4D-Game/CrazyComet/README.md

# CrazyComet

CrazyComet is a physical game wich can be controlled using gamepads. For more information take a look at the [documentation](https://Electronic-and-Computer-Engineering.github.io/CrazyComet/)
