4D-Game/CrazyComet/hardware/README.md

# Hardware
Plans and Gerber-Files for the needed Hardware
