4D-Game/CrazyComet/controller/README.md

# Streamer
Code for the streamer (e.g. Raspberry Pi)
