4D-Game/CrazyComet/docs/hardware/tower.md

# Tower

The tower is the central element of the playing field. It is used to move the comets around the playing field so every player has a chance to hit them.

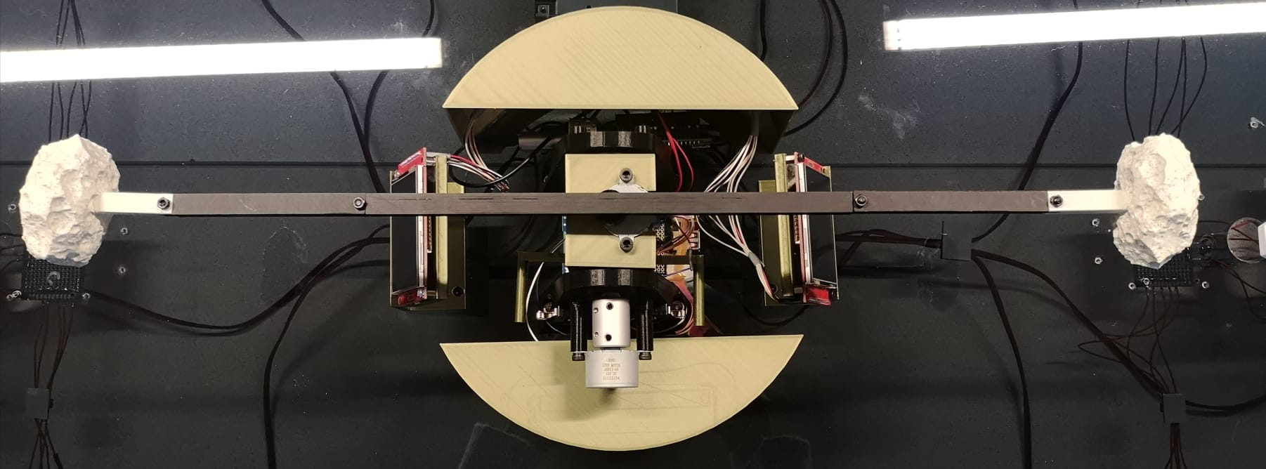
[picture p6: docs/assets/hardware/pictures/tower_top_view.jpeg]
View from the top


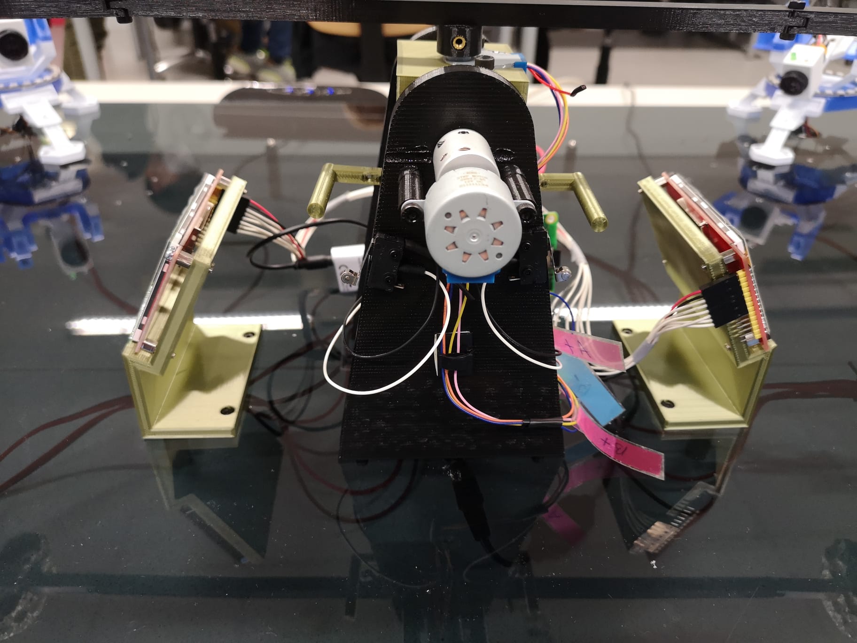
[picture p7: docs/assets/hardware/pictures/tower_side.jpeg]
View from the side


## Functionality

The tower consists of a base and an arm with a comet at each end. The arm can be rotated horizontally and tilted vertically. Both motions are created with a stepper motor. The stepper motors are controlled with the Raspberry Pi using a Adafruit Motor Shield. In order to avoid tilting too far  to the right or left, 2 end stoppers and physical limitation are built in.

## Technical characteristics

| Mechanical Device  | Action | State |
| --- | --- | --- |
| Side stepper motor | Tilting the tower | +-16° right/left max |
| Top stepper motor  | Arm rotation | Circular movement |

### 3D-Model

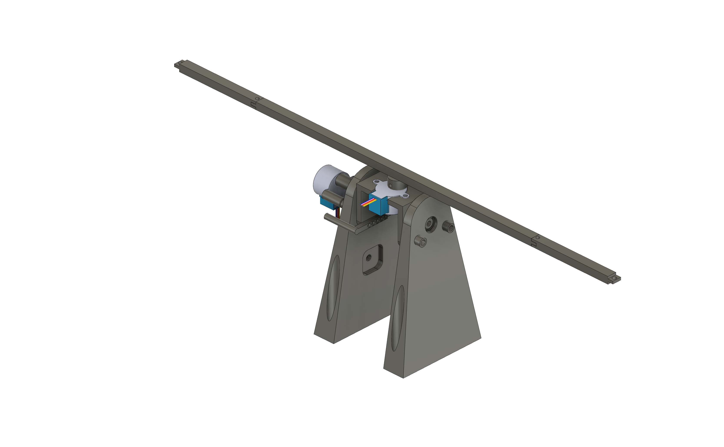
[picture p8: docs/assets/hardware/models/tower/tower_final.png]
CAD model of the tower


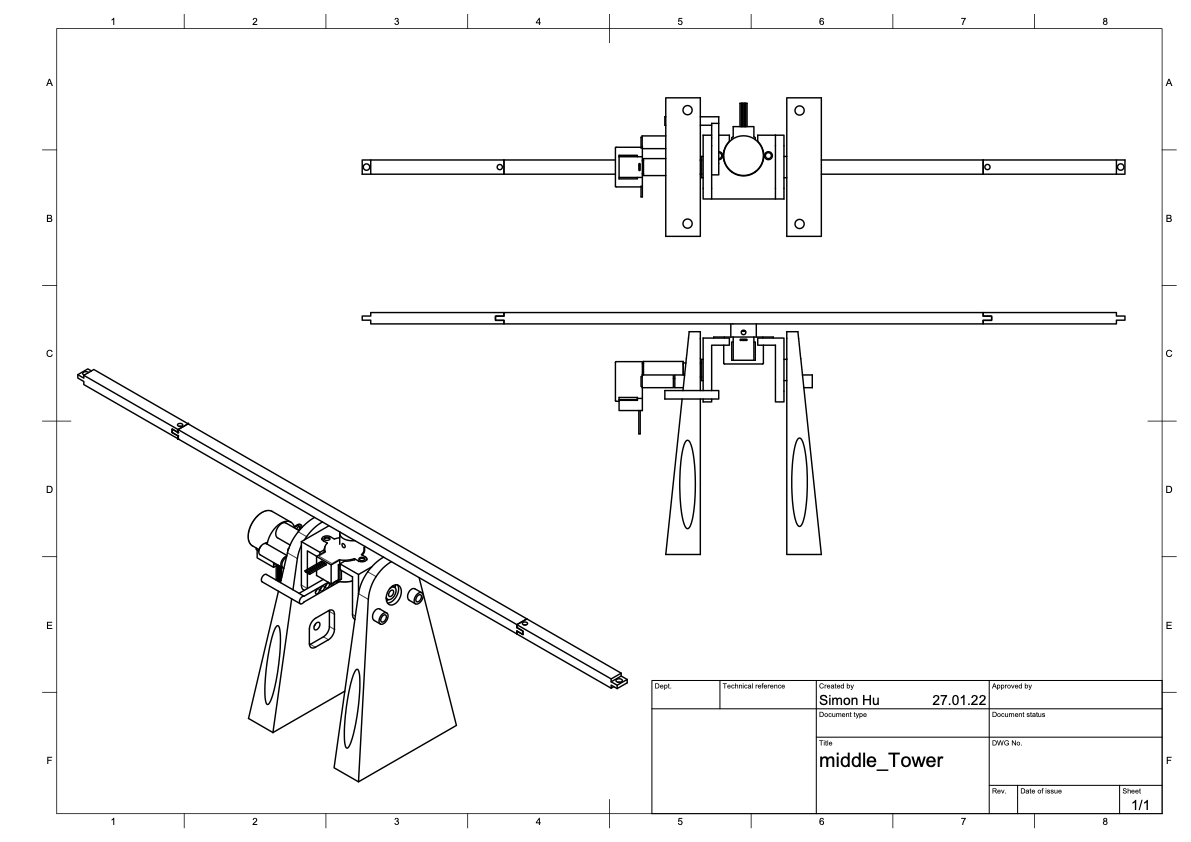
[picture p9: docs/assets/hardware/models/tower/tower_final_sketch.png]
CAD sketch of the tower


### Circuit (connection to Raspberry Pi)

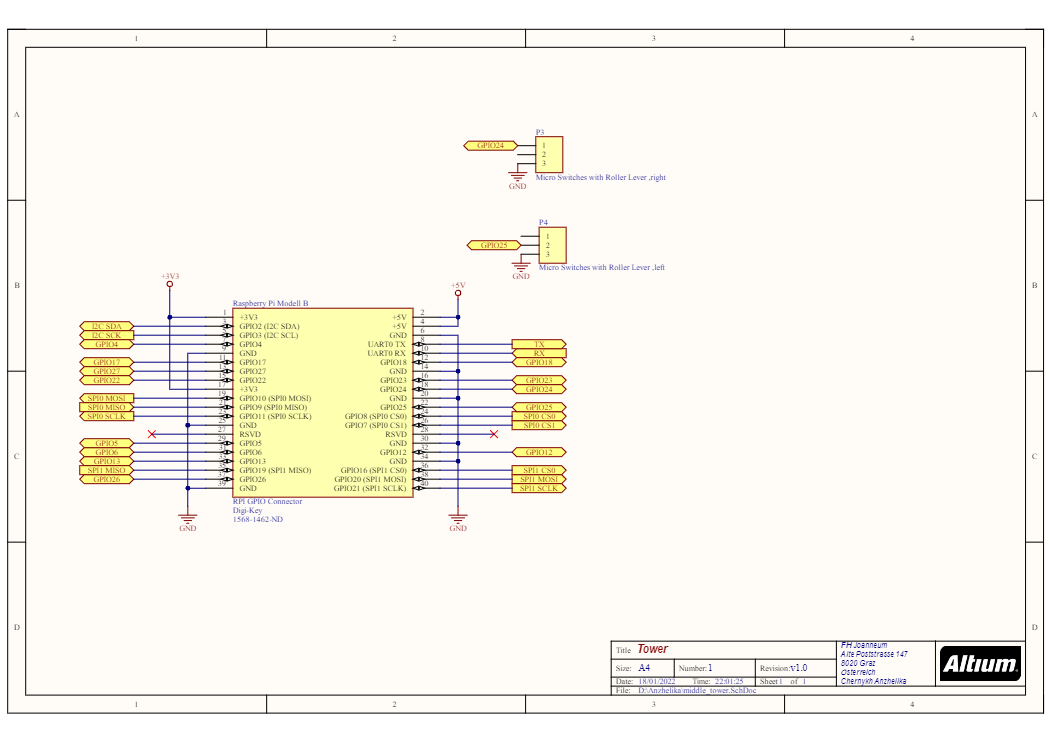
[picture p10: docs/assets/hardware/circuit/tower.png]
Middle Tower circuit


For the connection between motors, motor shield and Raspberry Pi see the [Adafruit documentation](https://learn.adafruit.com/adafruit-dc-and-stepper-motor-hat-for-raspberry-pi/stacking-hats)

## Components

For a list of all used components see the [components](components.md) section.

## Further information

All 3D-Models were done with Fusion360 and can be found on GitHub.
For information about controlling the tower via controller and software solutions please look [here](../gamecontrol/code-references/hardware/stepper_hal.md)
