4D-Game/CrazyComet/docs/gamecontrol/code-references/hardware/display_hal.md

# StepperHAL

:::gamecontrol.hardware.display_hal
