4D-Game/CrazyComet/docs/gamecontrol/code-references/hardware/sound_hal.md

# StepperHAL

:::gamecontrol.hardware.sound_hal
