4D-Game/CrazyComet/docs/gamecontrol/code-references/hardware/stepper_hal.md

# StepperHAL

:::gamecontrol.hardware.stepper_hal
