4D-Game/CrazyComet/docs/documentation.md

# Documentation

This documentation is generated by [MkDocs](https://www.mkdocs.org) with the [Material for MkDocs](https://squidfunk.github.io/mkdocs-material/) Theme. MkDocs is a static site generator wich uses Markdown as markup language. For a Markdown cheat sheet click [here](https://www.markdownguide.org/cheat-sheet).

## Setup

To use MkDocs the `requirements.txt` have to be installed with:

```bash
pip3 install -r requirements.txt
```

!!! INFO
    On the **Controller** and **Gamecontrol** Repository this only works on a Raspberry Pi

## Local build

To build the documentation for local use run:

```bash
mkdocs serve
```

Now you can access the documentation on the address shown in the terminal ([http://localhost:8000](http://localhost:8000))

!!! INFO
    When running on a Raspberry Pi execute the following command to access the Documentation from an other PC in the same network.

    ```bash
      mkdocs serve -a <ip of your raspberry pi>:8000
    ```

## Deploy

When the documentation is ready it can be uploaded to GitHub using:

```bash
mkdocs gh-deploy
```

This will automatically build an upload the site to GitHub using the branch *gh-pages*.

!!! WARNING
    Please avoid modifying the branch *gh-pages* manually.

## Useful Commands

### Diagrams

Diagrams can be created by using [mermaid](https://mermaid-js.github.io/mermaid/). Mermaid can be used by creating a code-block with the `mermaid` language tag.

````md
```mermaid
<your diagram>
```
````
