4D-Game/CrazyComet/docs/coding-style/cpp.md

# C++ Coding Style

Next to consistency as a main aspect of good code, the second most important aspect is a certain style which the average `c++` programmer is capable to read and understand properly. Therefore the following documents states the essential naming conventions.
> Here is a link for a more detailed dive into [`c++ core guidelines'](https://github.com/isocpp/CppCoreGuidelines/blob/master/CppCoreGuidelines.md)

## Naming conventions
### Variables

The name of a variable should be as accurate as possible and as short as possible at the same time.

*Example:*
```cpp
// don't
int x;
x = 10 + 5;
// do
int sum
sum = 10 + 5;
```
A variable can be used in two different scenarios.

**Global variables** are defined outside of all functions, usually on top of the program. The variable will hold their value throughout the lifetime of the program.
Global variables should be defined in a **snake_case** style, when possible at the start of the file.

*Example:*
```cpp
int global_variable;
```

**Local variables** are defined, initially set and consumed within a function, method or block. These variables lifetime is confined within the lifetime (time of execution) of a function (method or block).
Local variables should be defined the same way as global variables. The main difference for local variables is a defined prefix `m_`. `m_` stands for "member" data.
```cpp
int m_local_variable;
```

### Constants & Preprocessor Values
Constants are expressions with a fixed value. They are defined with the *key* `const. The naming convention for constants and preprocessor values prescribes that all letters are upper case letters with snake case subdivision

*Example:*
```cpp
#define PI_VALUE 3.14159

const int PI_VALUE = 3.14159;
```

### Functions
Functions can be written as *non-returning* and *returning* type. They should start with a **lower case** letter. The following word should be **upper case**. This method is called *camelCase*

*Example:*
```cpp
void exampleFuntion() {
   // do some stuff
}
```

### Classes (Types, Template parameters)
`C++` is a object-oriented programming language. Therefore it's all about creating objects which contain both data and functions for a certain task.

A class as well as an object should be defined with **PascalCase** notation.

*Example:*
```cpp
class Car {
  public:
    string brand;
    int max_speed;
    int power;
    Car(string ini_brand, int ini_speed, ini_power){
       brand = ini_brand;
       max_speed = ini_speed;
       power = ini_power;
    }

  private:
    int m_current_speed;
};

void GeneralCar::setSpeed(int new_speed){
    m_current_speed = new_speed;
}

int main(){
   // declaration of two objects
   Car car1("Auto1", 200, 100);
   Car car2("Auto2", 300, 200);

   //setting the speed
   car1.setSpeed(250);

   return 0;
}
```

### Comments
If the section of code is not clearly understandable there should be a short description of the current function in form of a comment.

*Example*
```cpp
// divides up two double values
double division(double dividend, double divisor){
   return (dividend / divisor);
}
```

**Documentation:**

The documentation of the written code is created automatically. To provide the needed Information every function, class or method needs a descriptive block comment (`/** */`) with a special format.
> For a detailed explanation click [here](https://www.doxygen.nl/manual/docblocks.html)

*Example:*
```cpp
/**
  <Description>

  @param some_variable
  <Description of some_variable>

  @return <Description>
*/
int someFunction(char some_variable) {

}
```

**Head of File:**

In order to get quick information about the `.cpp` and `.hpp` files purpose there should be a *Header* comment included. Therefor the `/** */` format of commenting should be used.

*Example:*
```cpp
/**
  <Short description of the files function>

  Projekt:           <Name of the Projekt>
  Author:            <Authors Name>
  Date of Creation:  <Date>
*/
```
