4D-Game/CrazyComet/docs/assets/concept.jpeg

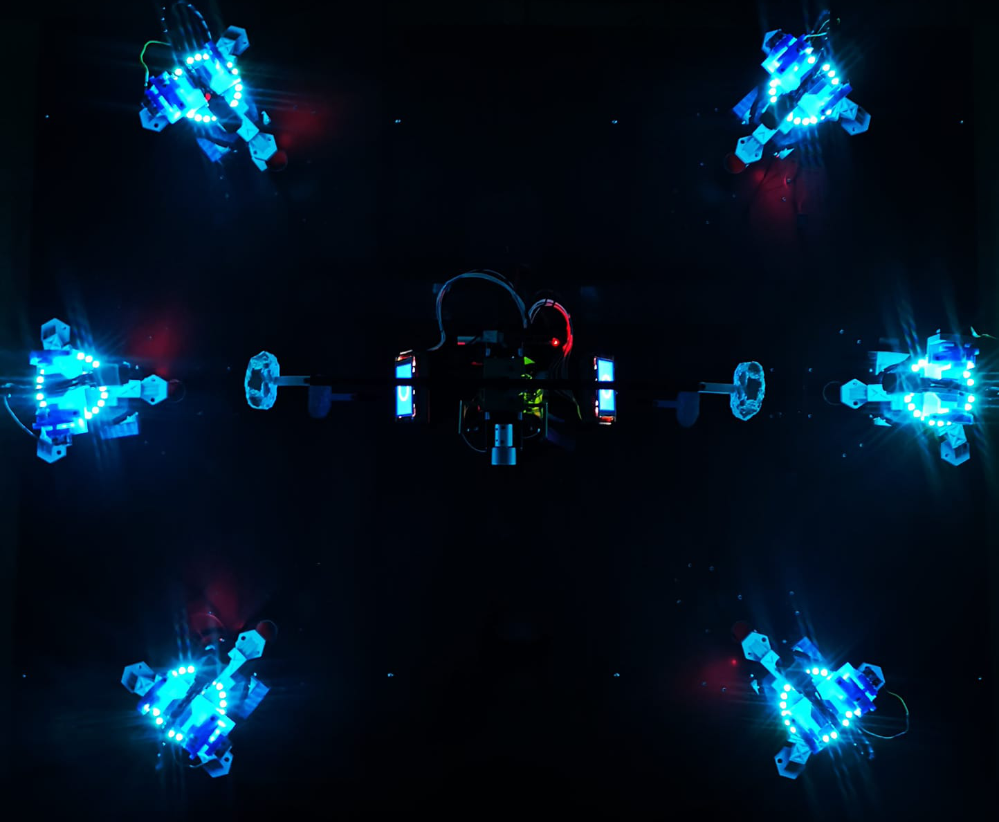
docs/assets/concept.jpeg
