4D-Game/CrazyComet/docs/assets/hardware/models/tower/tower_v1.png

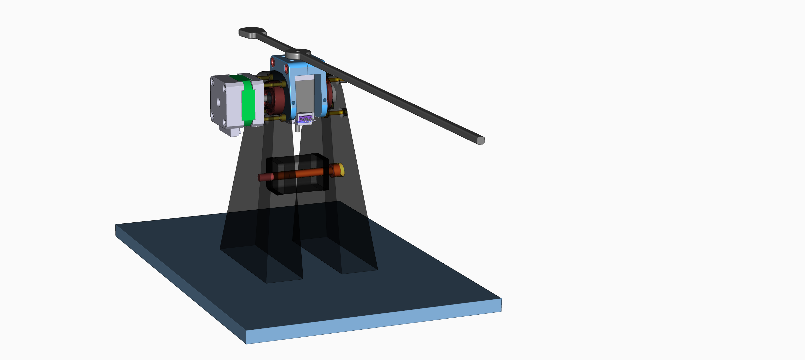
docs/assets/hardware/models/tower/tower_v1.png
