4D-Game/CrazyComet/docs/assets/hardware/models/turrets/base.png

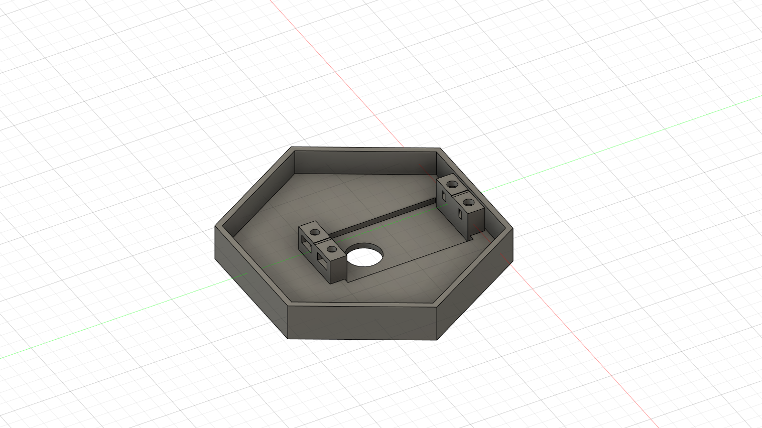
docs/assets/hardware/models/turrets/base.png
