4D-Game/CrazyComet/docs/assets/hardware/models/turrets/base_mount.png

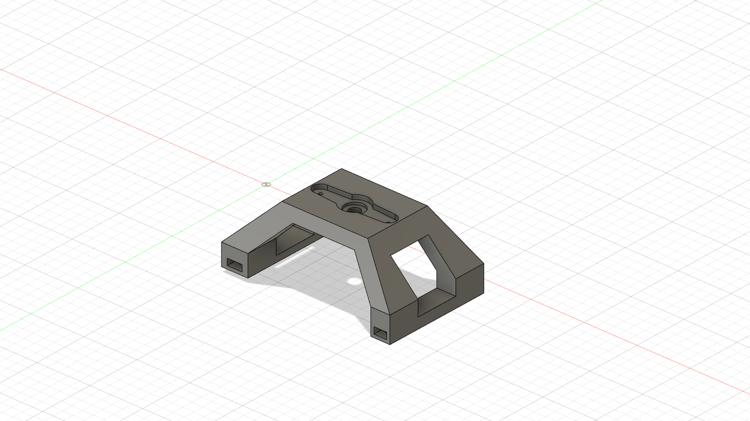
docs/assets/hardware/models/turrets/base_mount.png
