4D-Game/CrazyComet/docs/assets/hardware/models/turrets/blaster_arm.png

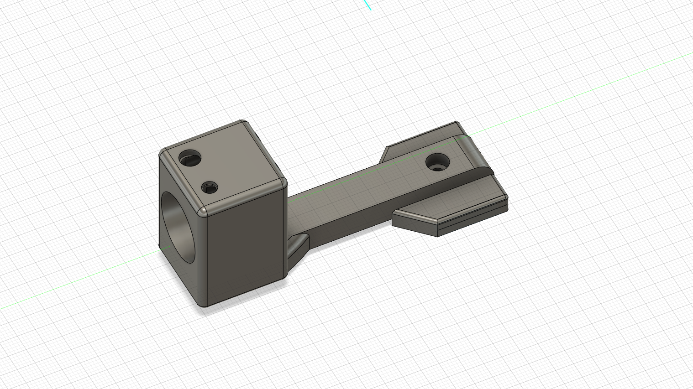
docs/assets/hardware/models/turrets/blaster_arm.png
