4D-Game/CrazyComet/docs/assets/hardware/models/turrets/end_bearing.png

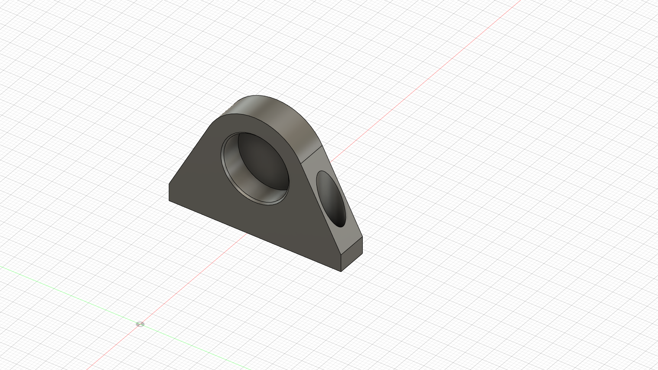
docs/assets/hardware/models/turrets/end_bearing.png
