4D-Game/CrazyComet/docs/assets/hardware/models/turrets/full_turret.png

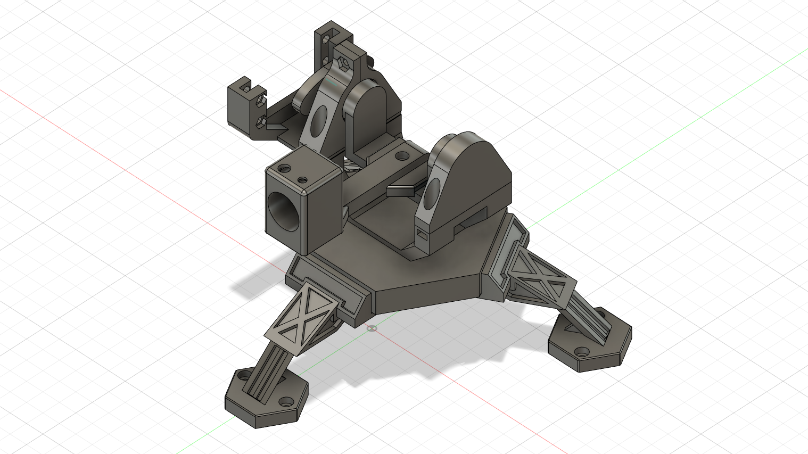
docs/assets/hardware/models/turrets/full_turret.png
