4D-Game/CrazyComet/docs/assets/hardware/models/turrets/left_right_bearing_half.png

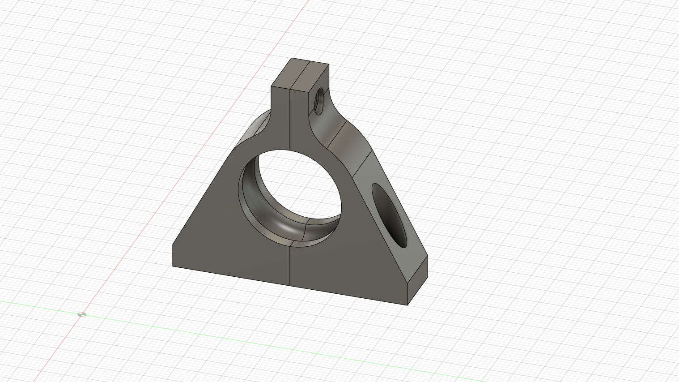
docs/assets/hardware/models/turrets/left_right_bearing_half.png
