4D-Game/CrazyComet/docs/assets/hardware/models/turrets/leg.png

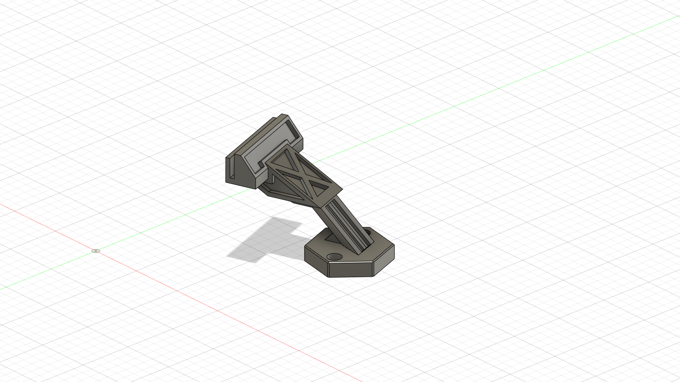
docs/assets/hardware/models/turrets/leg.png
