4D-Game/CrazyComet/docs/assets/hardware/models/turrets/turret_top.png

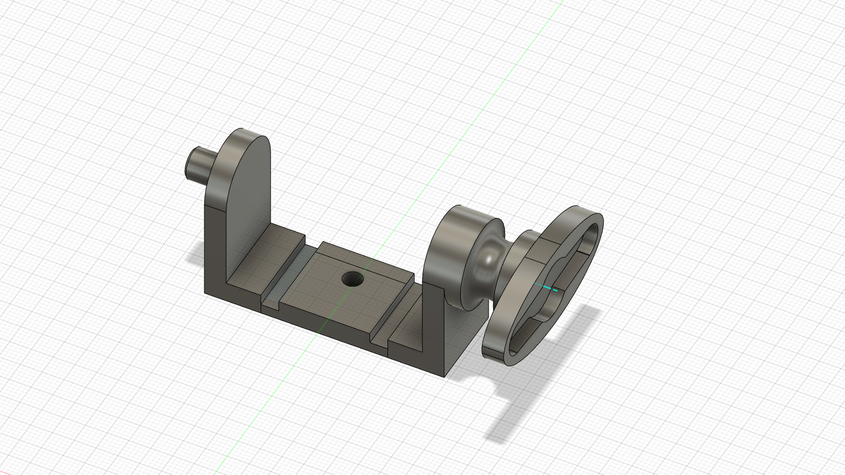
docs/assets/hardware/models/turrets/turret_top.png
