4D-Game/CrazyComet/docs/assets/hardware/models/turrets/vertical_servo_mount.png

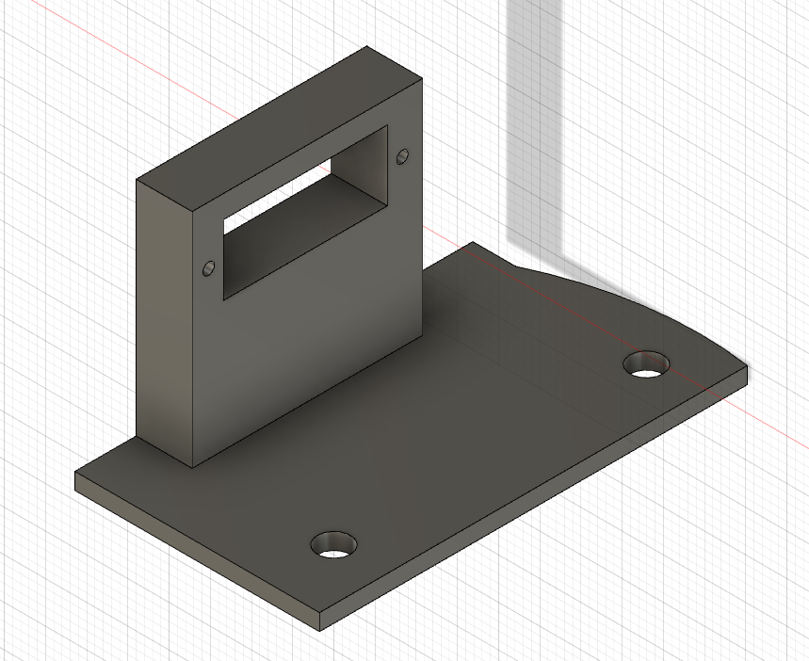
docs/assets/hardware/models/turrets/vertical_servo_mount.png
