4D-Game/CrazyComet/docs/assets/hardware/pictures/concept.jpeg

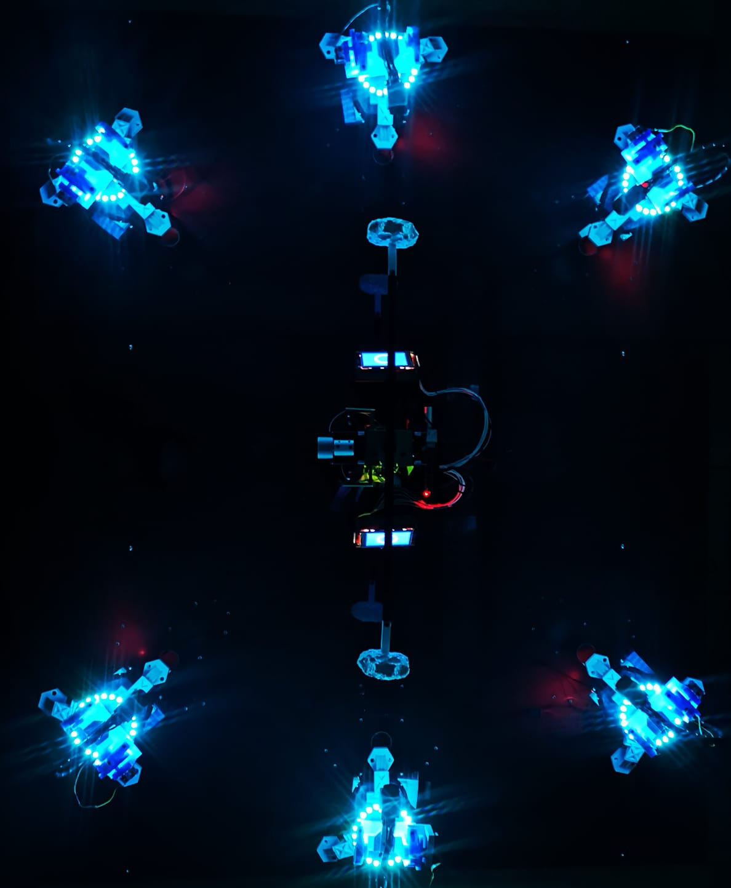
docs/assets/hardware/pictures/concept.jpeg
