4D-Game/CrazyComet/docs/assets/hardware/pictures/turret_front.jpeg

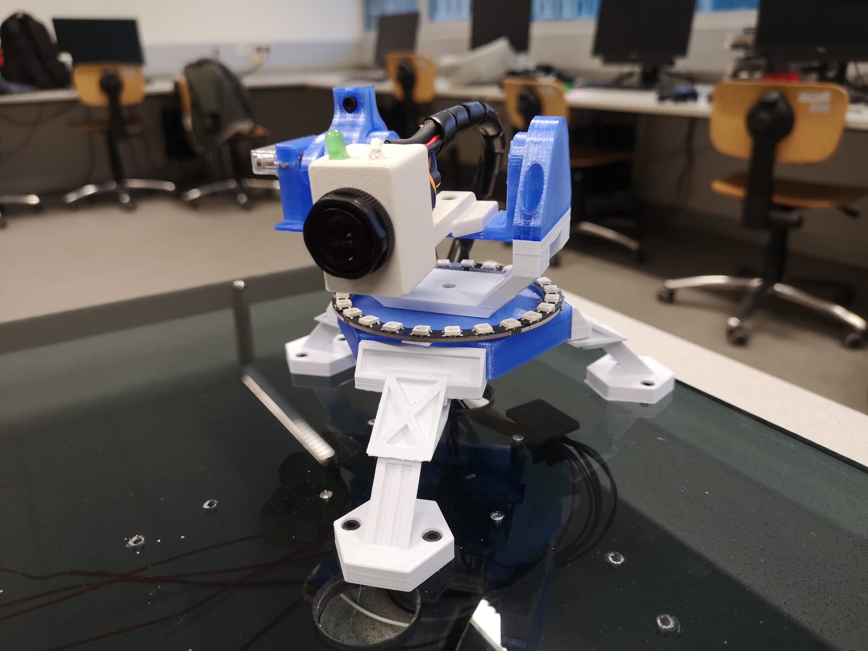
docs/assets/hardware/pictures/turret_front.jpeg
