4D-Game/CrazyComet/docs/assets/hardware/pictures/turret_left.jpeg

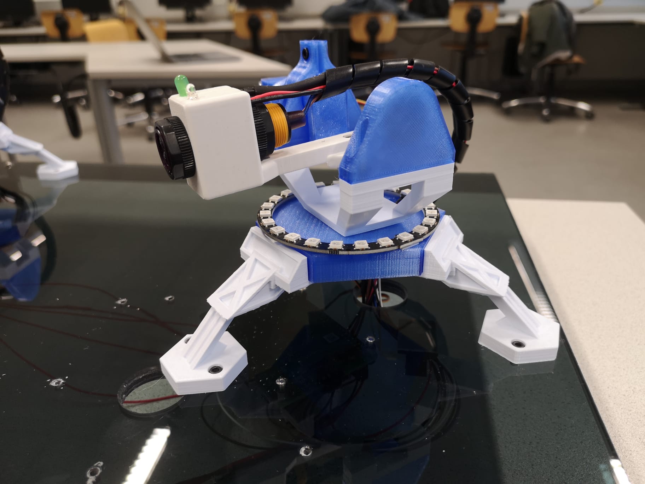
docs/assets/hardware/pictures/turret_left.jpeg
