4D-Game/CrazyComet/docs/assets/hardware/pictures/turret_top.jpeg

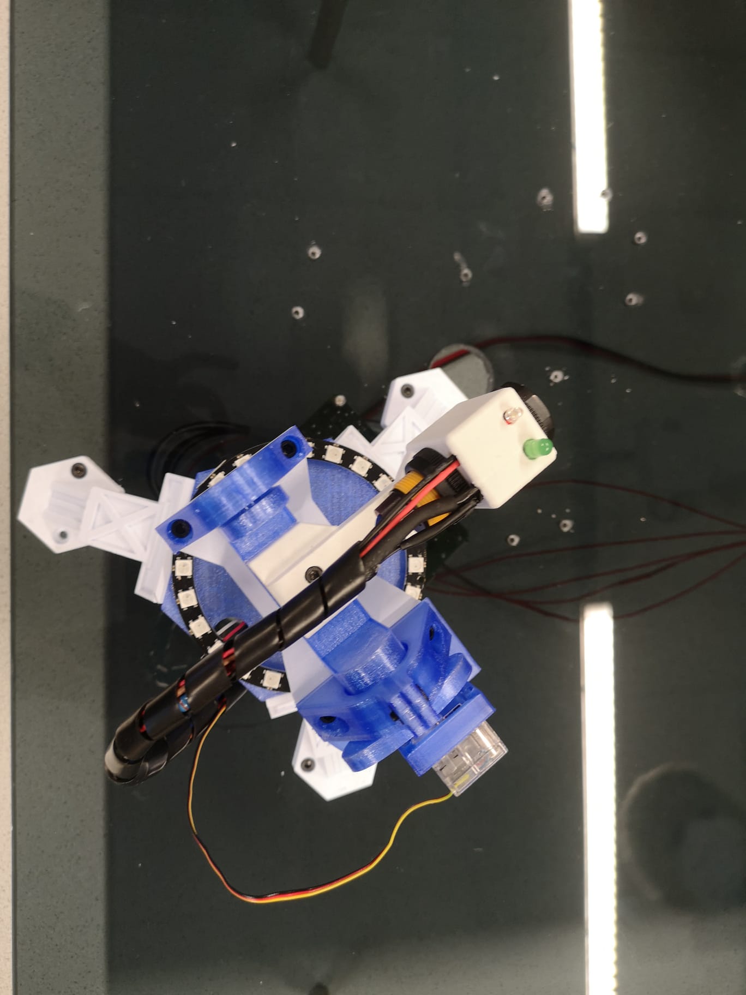
docs/assets/hardware/pictures/turret_top.jpeg
