4D-Game/CrazyComet/docs/assets/hardware/models/base_plate/base_plate.stl

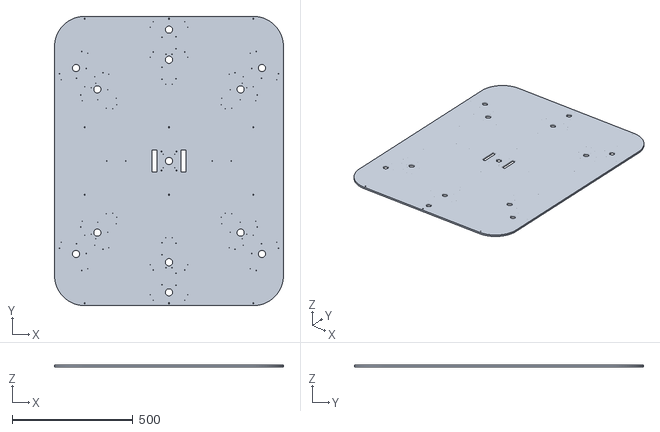
[picture p32: CAD file, 2022-03-05]
docs/assets/hardware/models/base_plate/base_plate.stl
950.0 x 1200.0 x 8.00
