4D-Game/CrazyComet/docs/assets/hardware/models/display/display_mount.stl

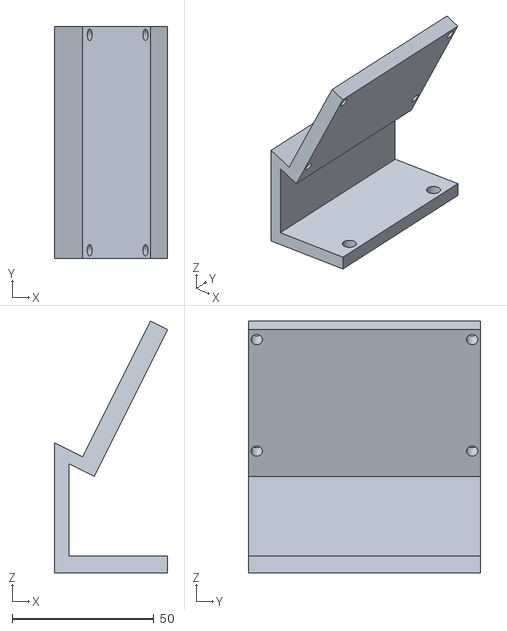
[picture p33: CAD file, 2022-03-05]
docs/assets/hardware/models/display/display_mount.stl
40.0 x 82.0 x 88.9
