4D-Game/CrazyComet/docs/assets/hardware/models/tower/tower.stl

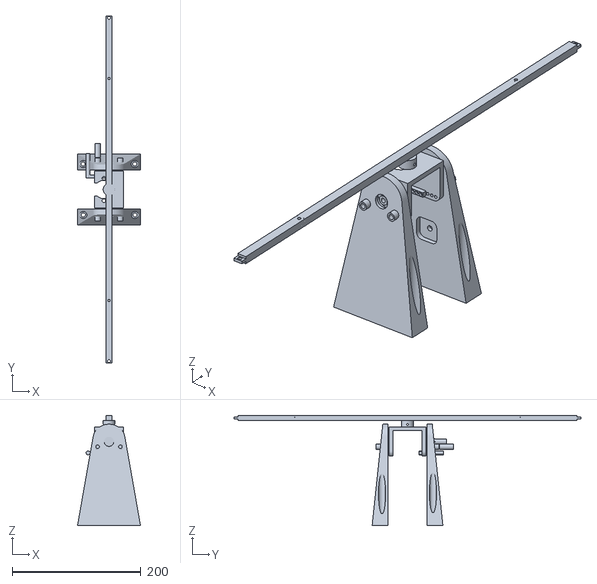
[picture p34: CAD file, 2022-03-05]
docs/assets/hardware/models/tower/tower.stl
97.7 x 538.1 x 170.6
