4D-Game/CrazyComet/docs/assets/hardware/models/turrets/blanko_hyx_s3001/servo_adapter_blanko.stl

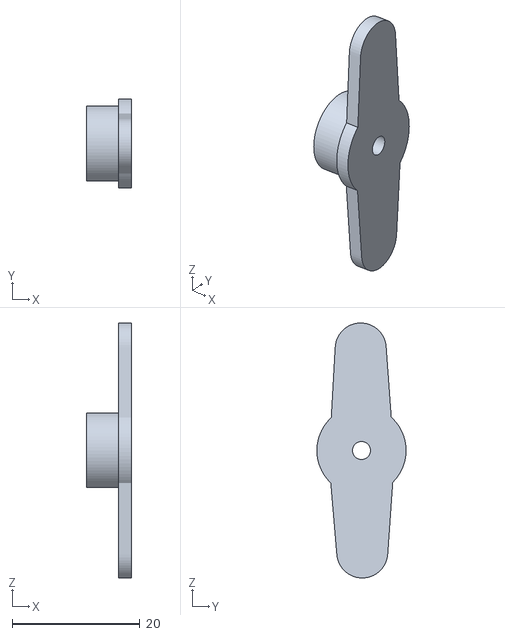
[picture p35: CAD file, 2022-03-05]
docs/assets/hardware/models/turrets/blanko_hyx_s3001/servo_adapter_blanko.stl
7.00 x 14.0 x 40.0
