4D-Game/CrazyComet/docs/assets/hardware/models/turrets/turret_top.stl

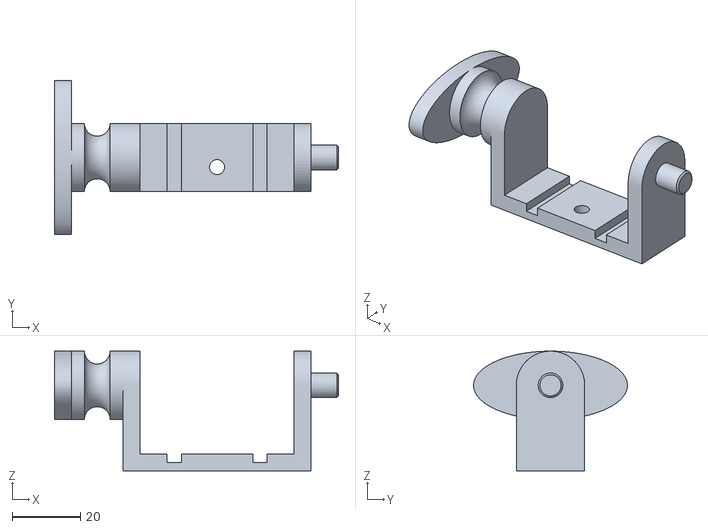
[picture p36: CAD file, 2022-03-05]
docs/assets/hardware/models/turrets/turret_top.stl
83.0 x 45.0 x 35.0
