4D-Game/CrazyComet/hardware/models/turrets/blanko_hyx_s3001/servo_bracket_blanko.stl

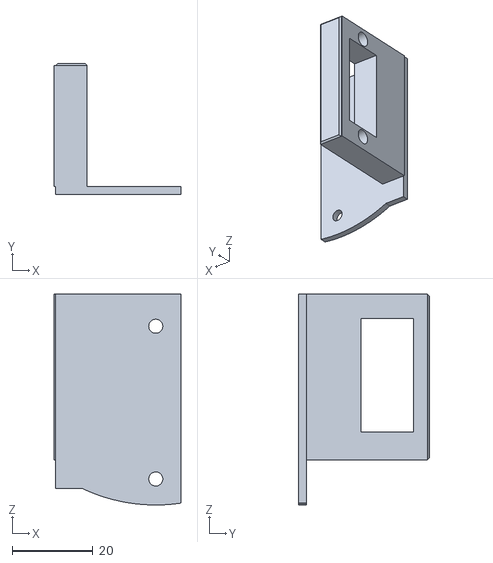
[picture p37: CAD file, 2022-03-05]
hardware/models/turrets/blanko_hyx_s3001/servo_bracket_blanko.stl
31.5 x 32.5 x 52.4
