4D-Game/CrazyComet/hardware/models/turrets/end_bearing.stl

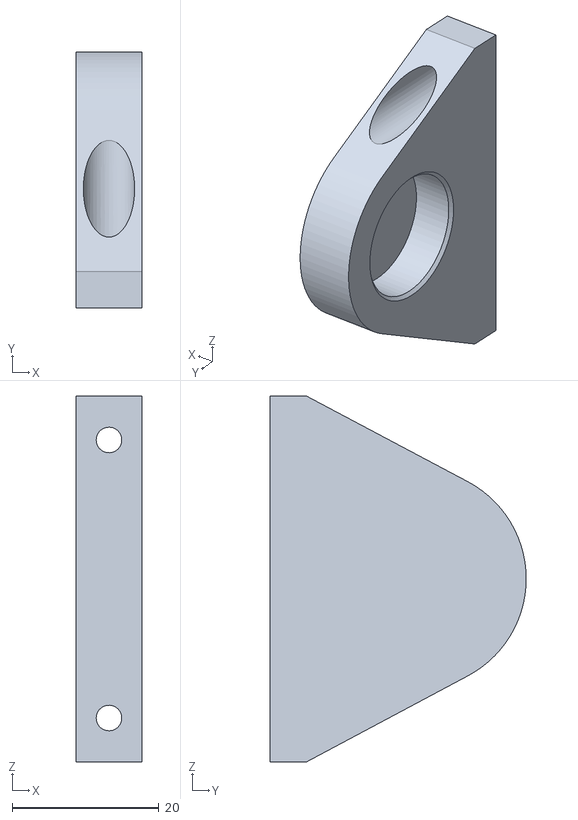
[picture p38: CAD file, 2022-03-05]
hardware/models/turrets/end_bearing.stl
9.00 x 35.0 x 49.9
