4D-Game/CrazyComet/docs/assets/hardware/models/turrets/base.stl

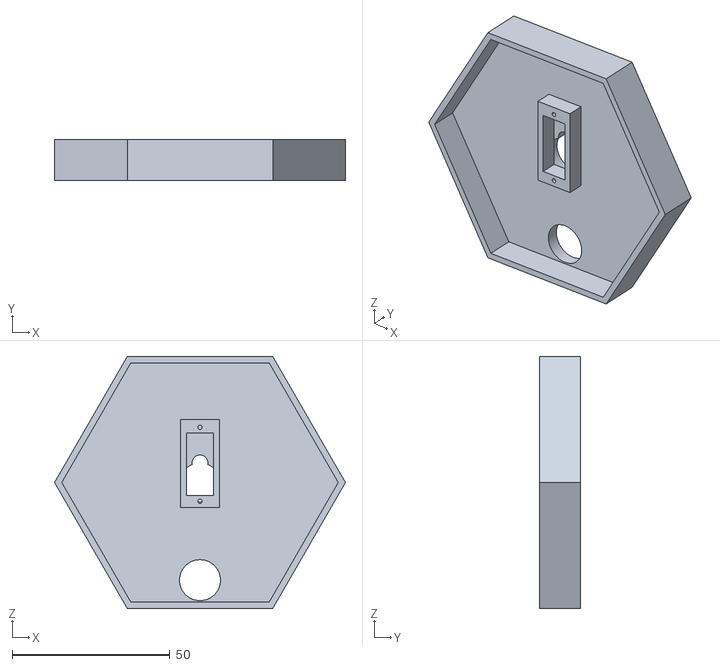
[picture p39: CAD file, 2022-03-05]
docs/assets/hardware/models/turrets/base.stl
92.4 x 13.0 x 80.0
