4D-Game/CrazyComet/hardware/models/turrets/leg.stl

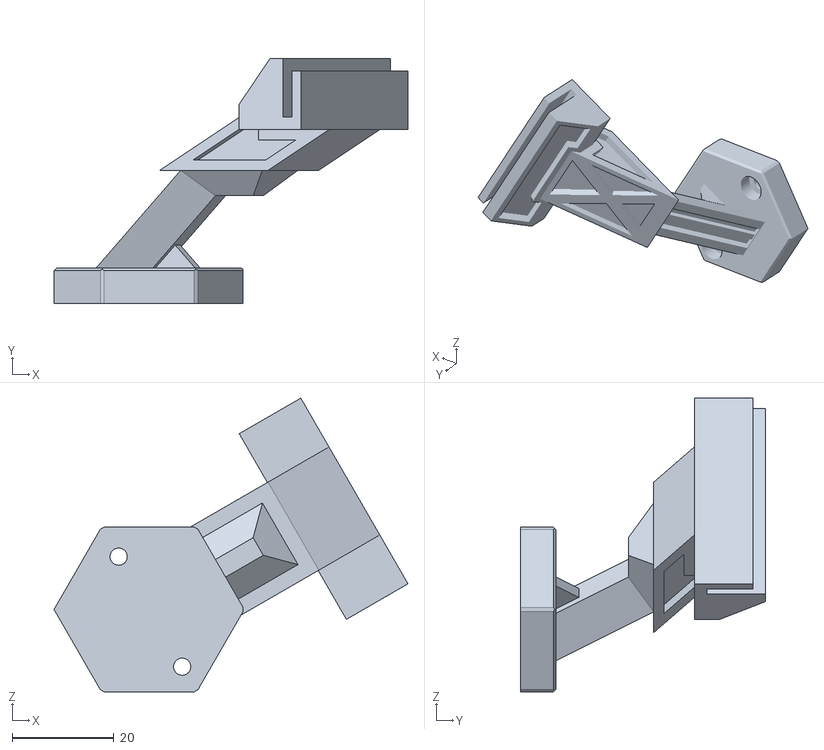
[picture p40: CAD file, 2022-03-05]
hardware/models/turrets/leg.stl
69.7 x 48.2 x 57.8
