4D-Game/CrazyComet/docs/assets/hardware/models/turrets/vertical_servo_mount_v2.stl

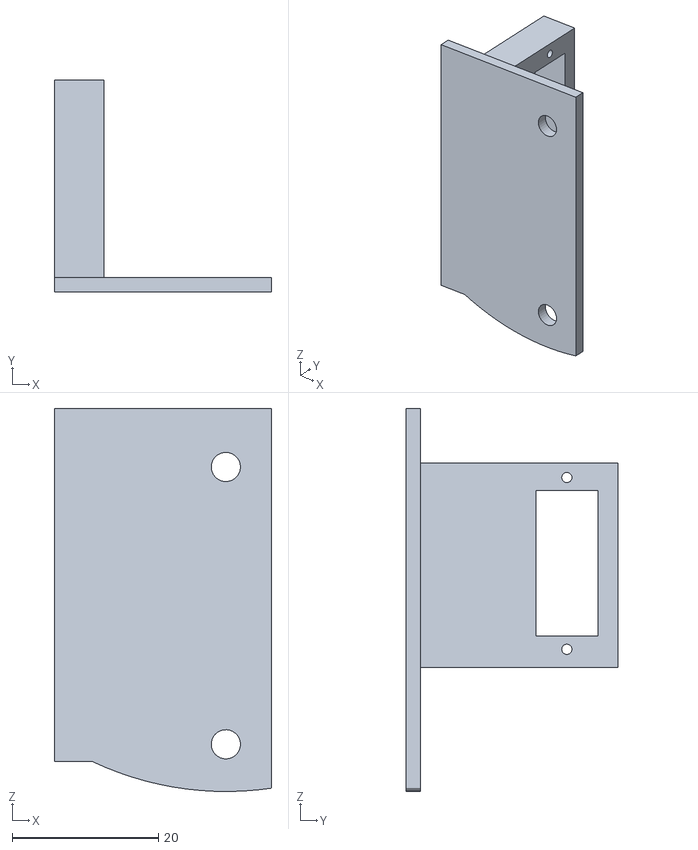
[picture p41: CAD file, 2022-03-05]
docs/assets/hardware/models/turrets/vertical_servo_mount_v2.stl
29.7 x 29.0 x 52.4
