4D-Game/CrazyComet/docs/assets/hardware/models/turrets/base_mount.stl

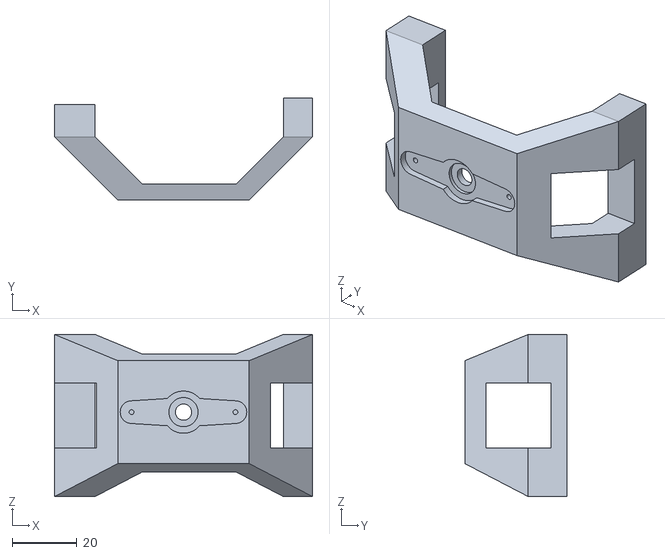
[picture p42: CAD file, 2022-03-05]
docs/assets/hardware/models/turrets/base_mount.stl
79.5 x 31.5 x 49.9
