4D-Game/CrazyComet/hardware/models/turrets/right_bearing_half.stl

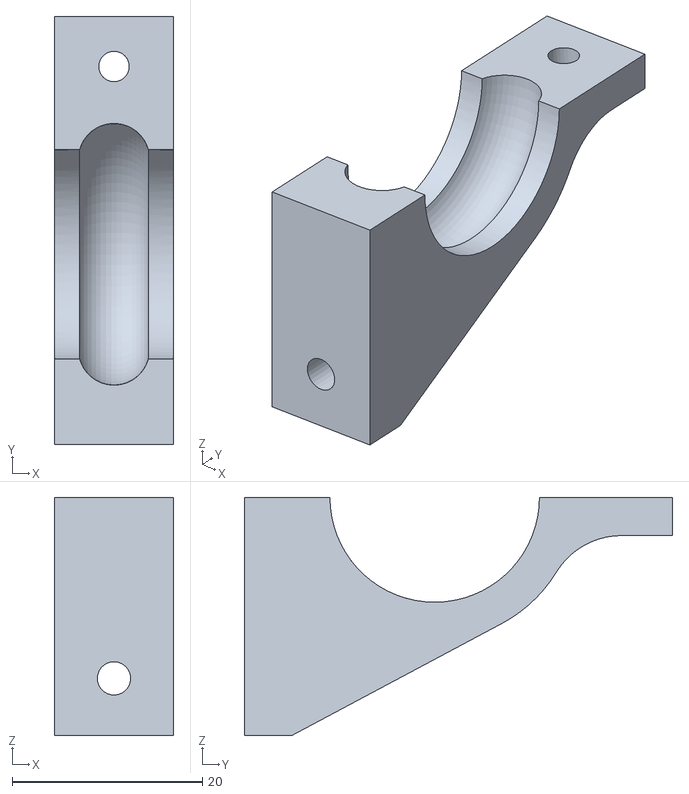
[picture p43: CAD file, 2022-03-05]
hardware/models/turrets/right_bearing_half.stl
12.5 x 45.0 x 25.0
