4D-Game/CrazyComet/docs/assets/hardware/models/turrets/servo_adapter_v2.stl

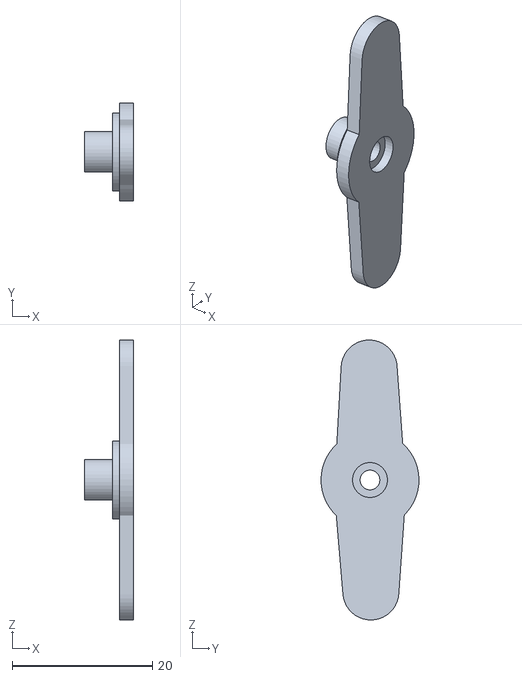
[picture p44: CAD file, 2022-03-05]
docs/assets/hardware/models/turrets/servo_adapter_v2.stl
7.00 x 14.0 x 40.0
