4D-Game/CrazyComet/docs/assets/hardware/models/turrets/blaster_arm_v3.stl

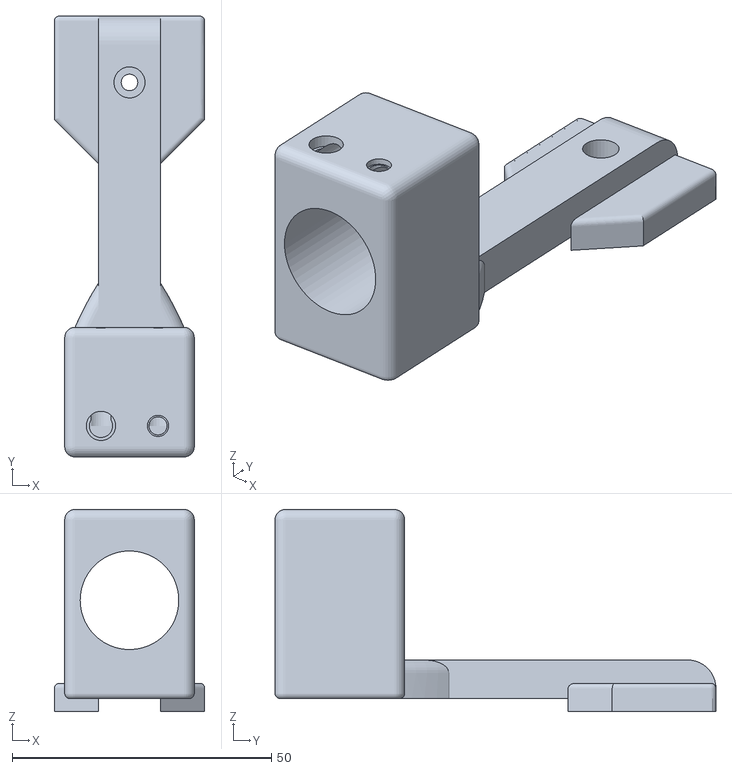
[picture p45: CAD file, 2022-03-05]
docs/assets/hardware/models/turrets/blaster_arm_v3.stl
29.0 x 85.0 x 38.9
