4D-Game/CrazyComet/(list of files, cad)

Other CAD files:
hardware/models/turrets/left_bearing_half.stl
docs/assets/hardware/models/turrets/left_bearing_half.stl
docs/assets/hardware/models/turrets/servo_adapter_v1.stl
hardware/models/turrets/servo_adapter_v1.stl
