4D-Game/CrazyComet/docs/assets/hardware/pictures/display_test.jpeg

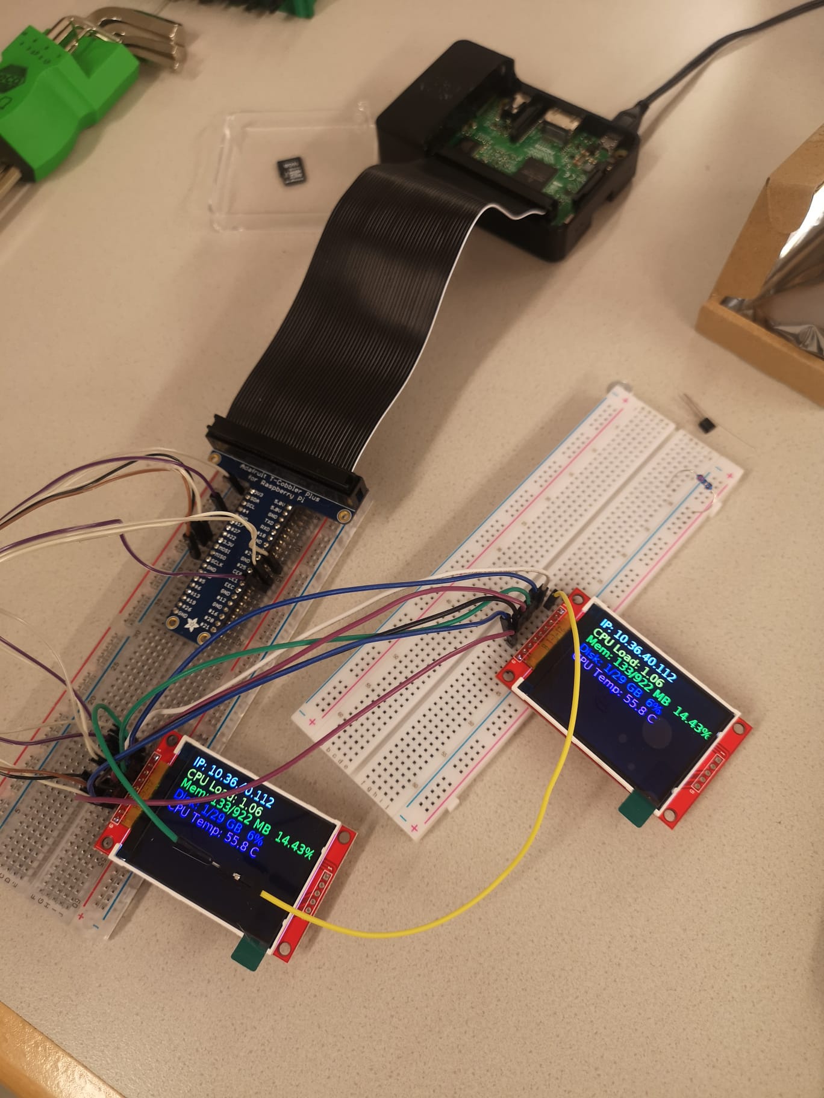
docs/assets/hardware/pictures/display_test.jpeg
