4D-Game/CrazyComet/hardware/circuit/turret.pdf

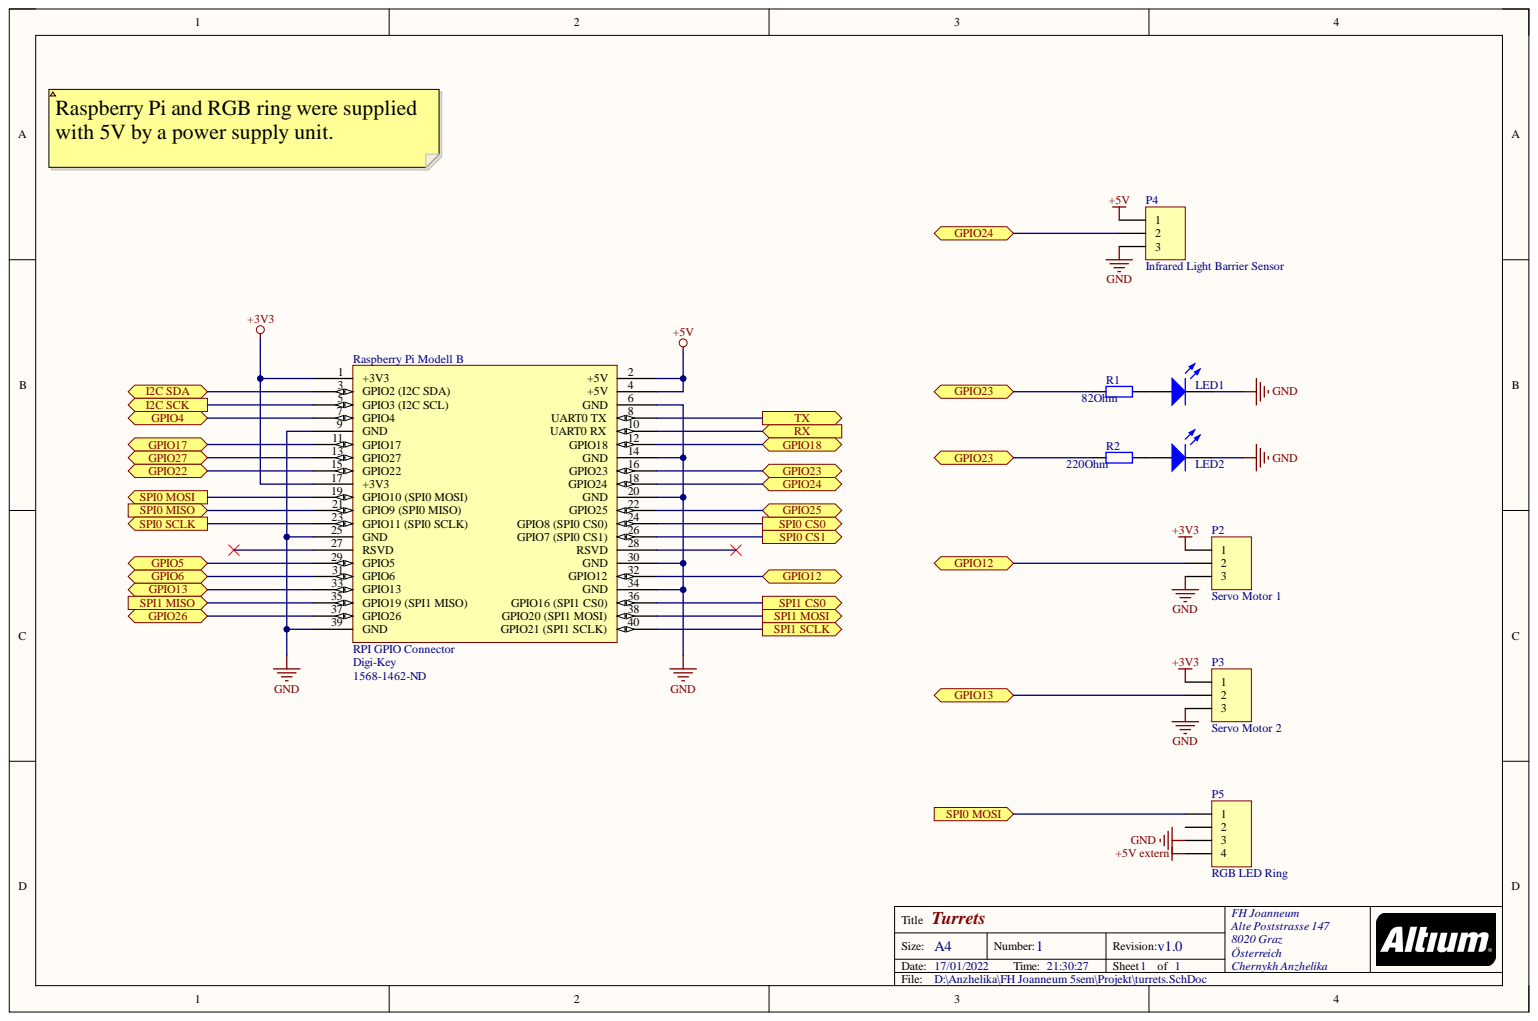
[picture p51: page 1]

Raspberry Pi and RGB ring were supplied
with 5V by a power supply unit.

D:\Anzhelika\FH Joanneum 5sem\Projekt\turrets.SchDoc
