4D-Game/CrazyComet/hardware/circuit/display.pdf

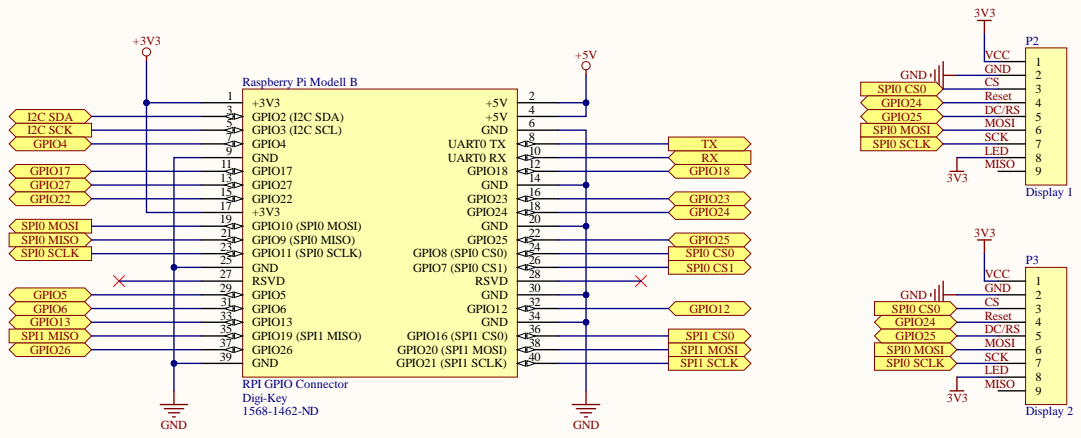
[picture p52: page 1]
