4D-Game/CrazyComet/hardware/circuit/tower.pdf

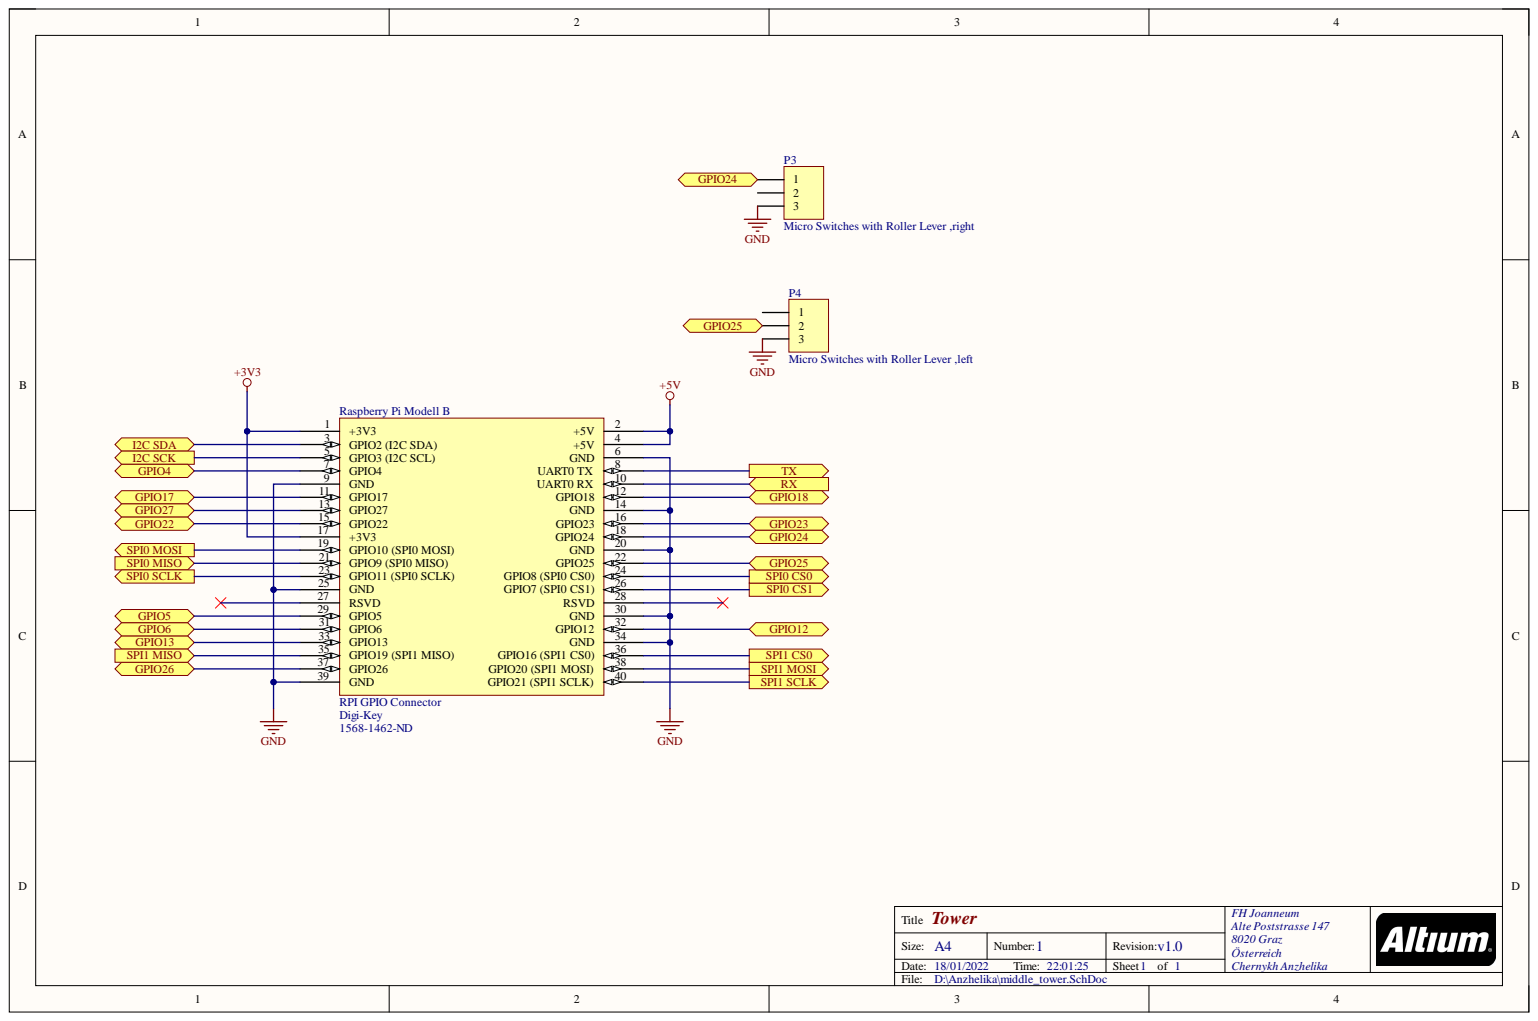
[picture p53: page 1]
