4D-Game/CrazyComet/hardware/models/base_plate/base_plate_A0.pdf

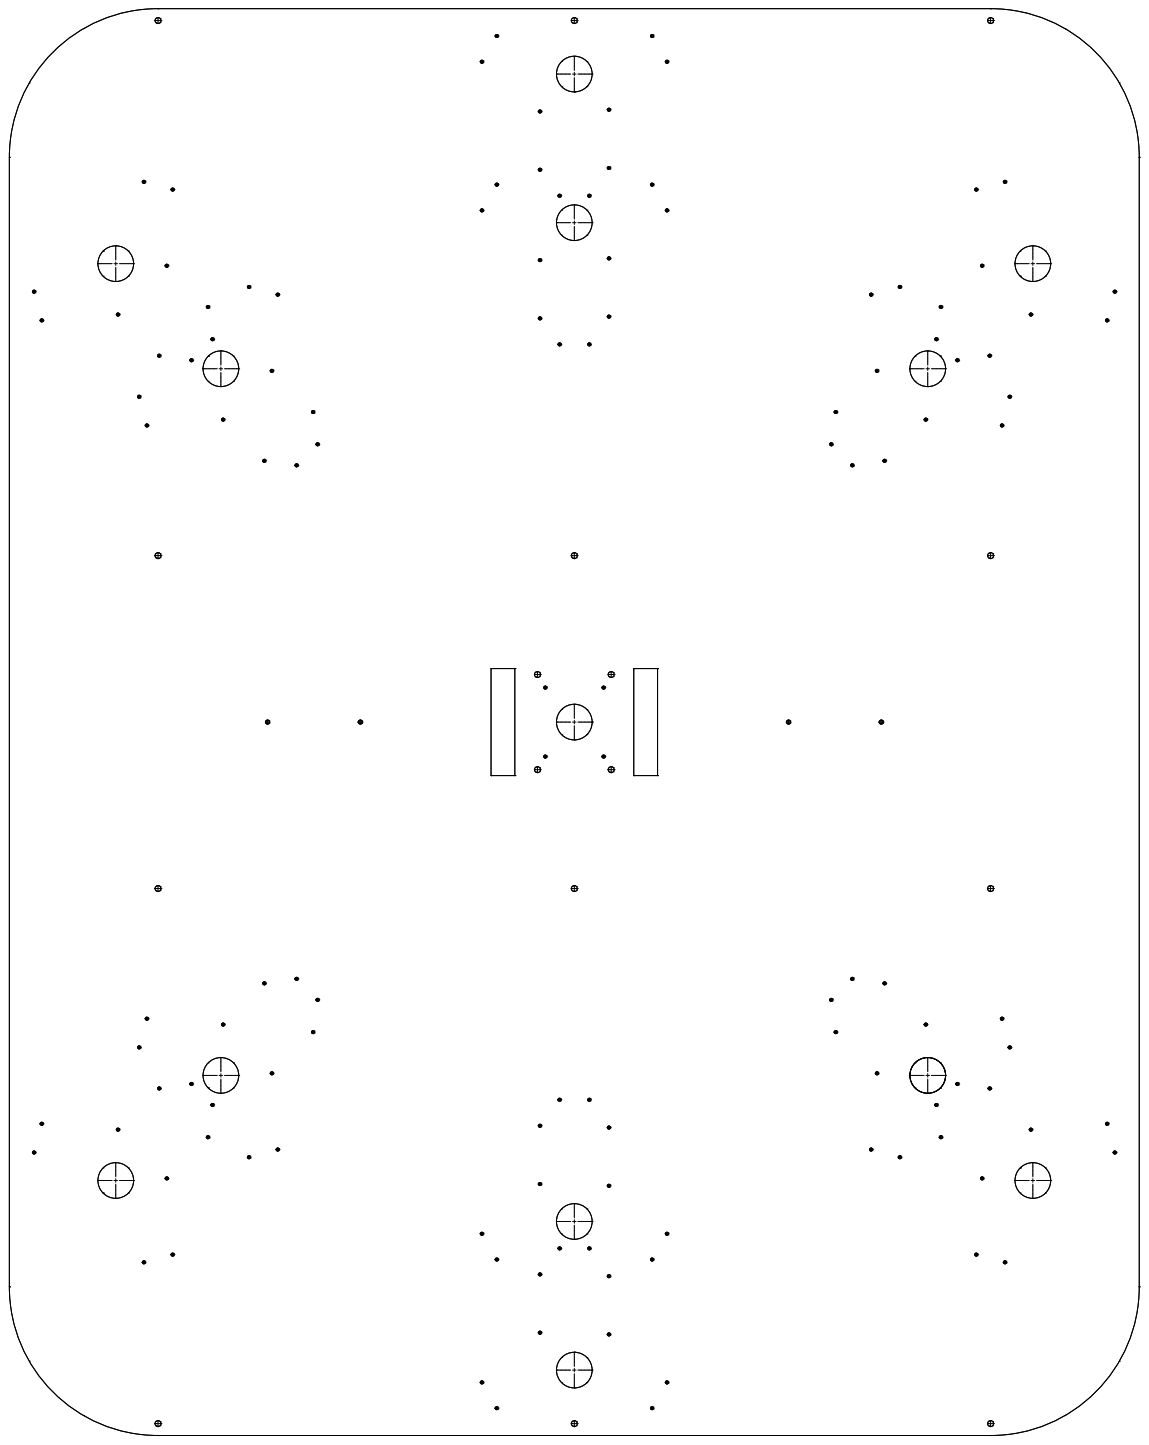
[picture p54: page 1]
