4D-Game/CrazyComet/hardware/models/tower/tower_final_sketch.pdf

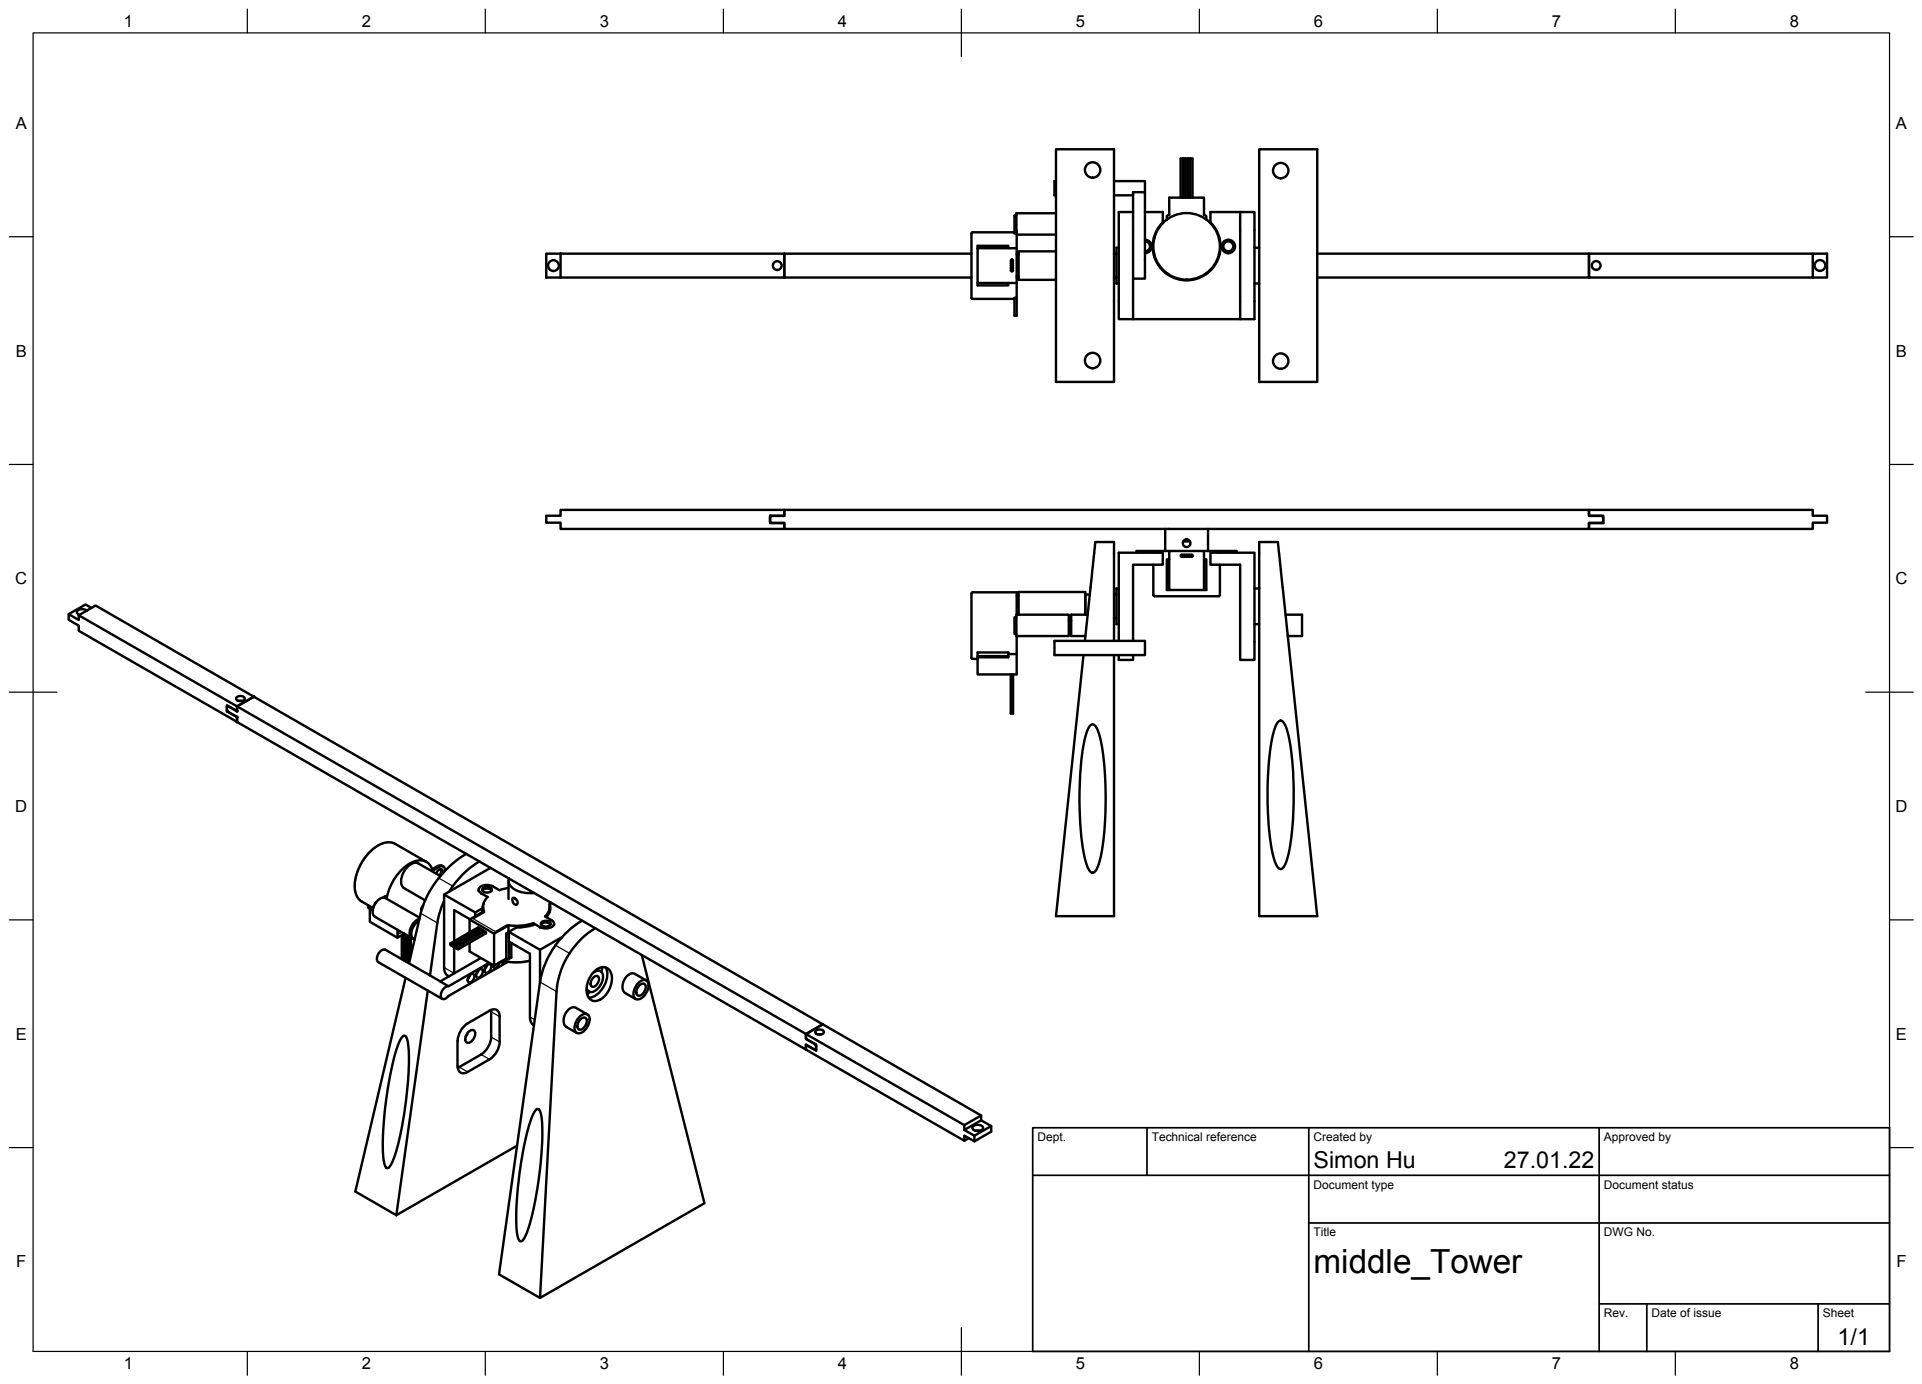
[picture p55: page 1]
Title; DWG No.; Rev.; Date of issue; Sheet

Dept. | Technical reference | Created by Simon Hu 27.01.22 | Approved by

Document type | Document status
