4D-Game/CrazyComet/hardware/models/tower/tower_sketch_v1.pdf

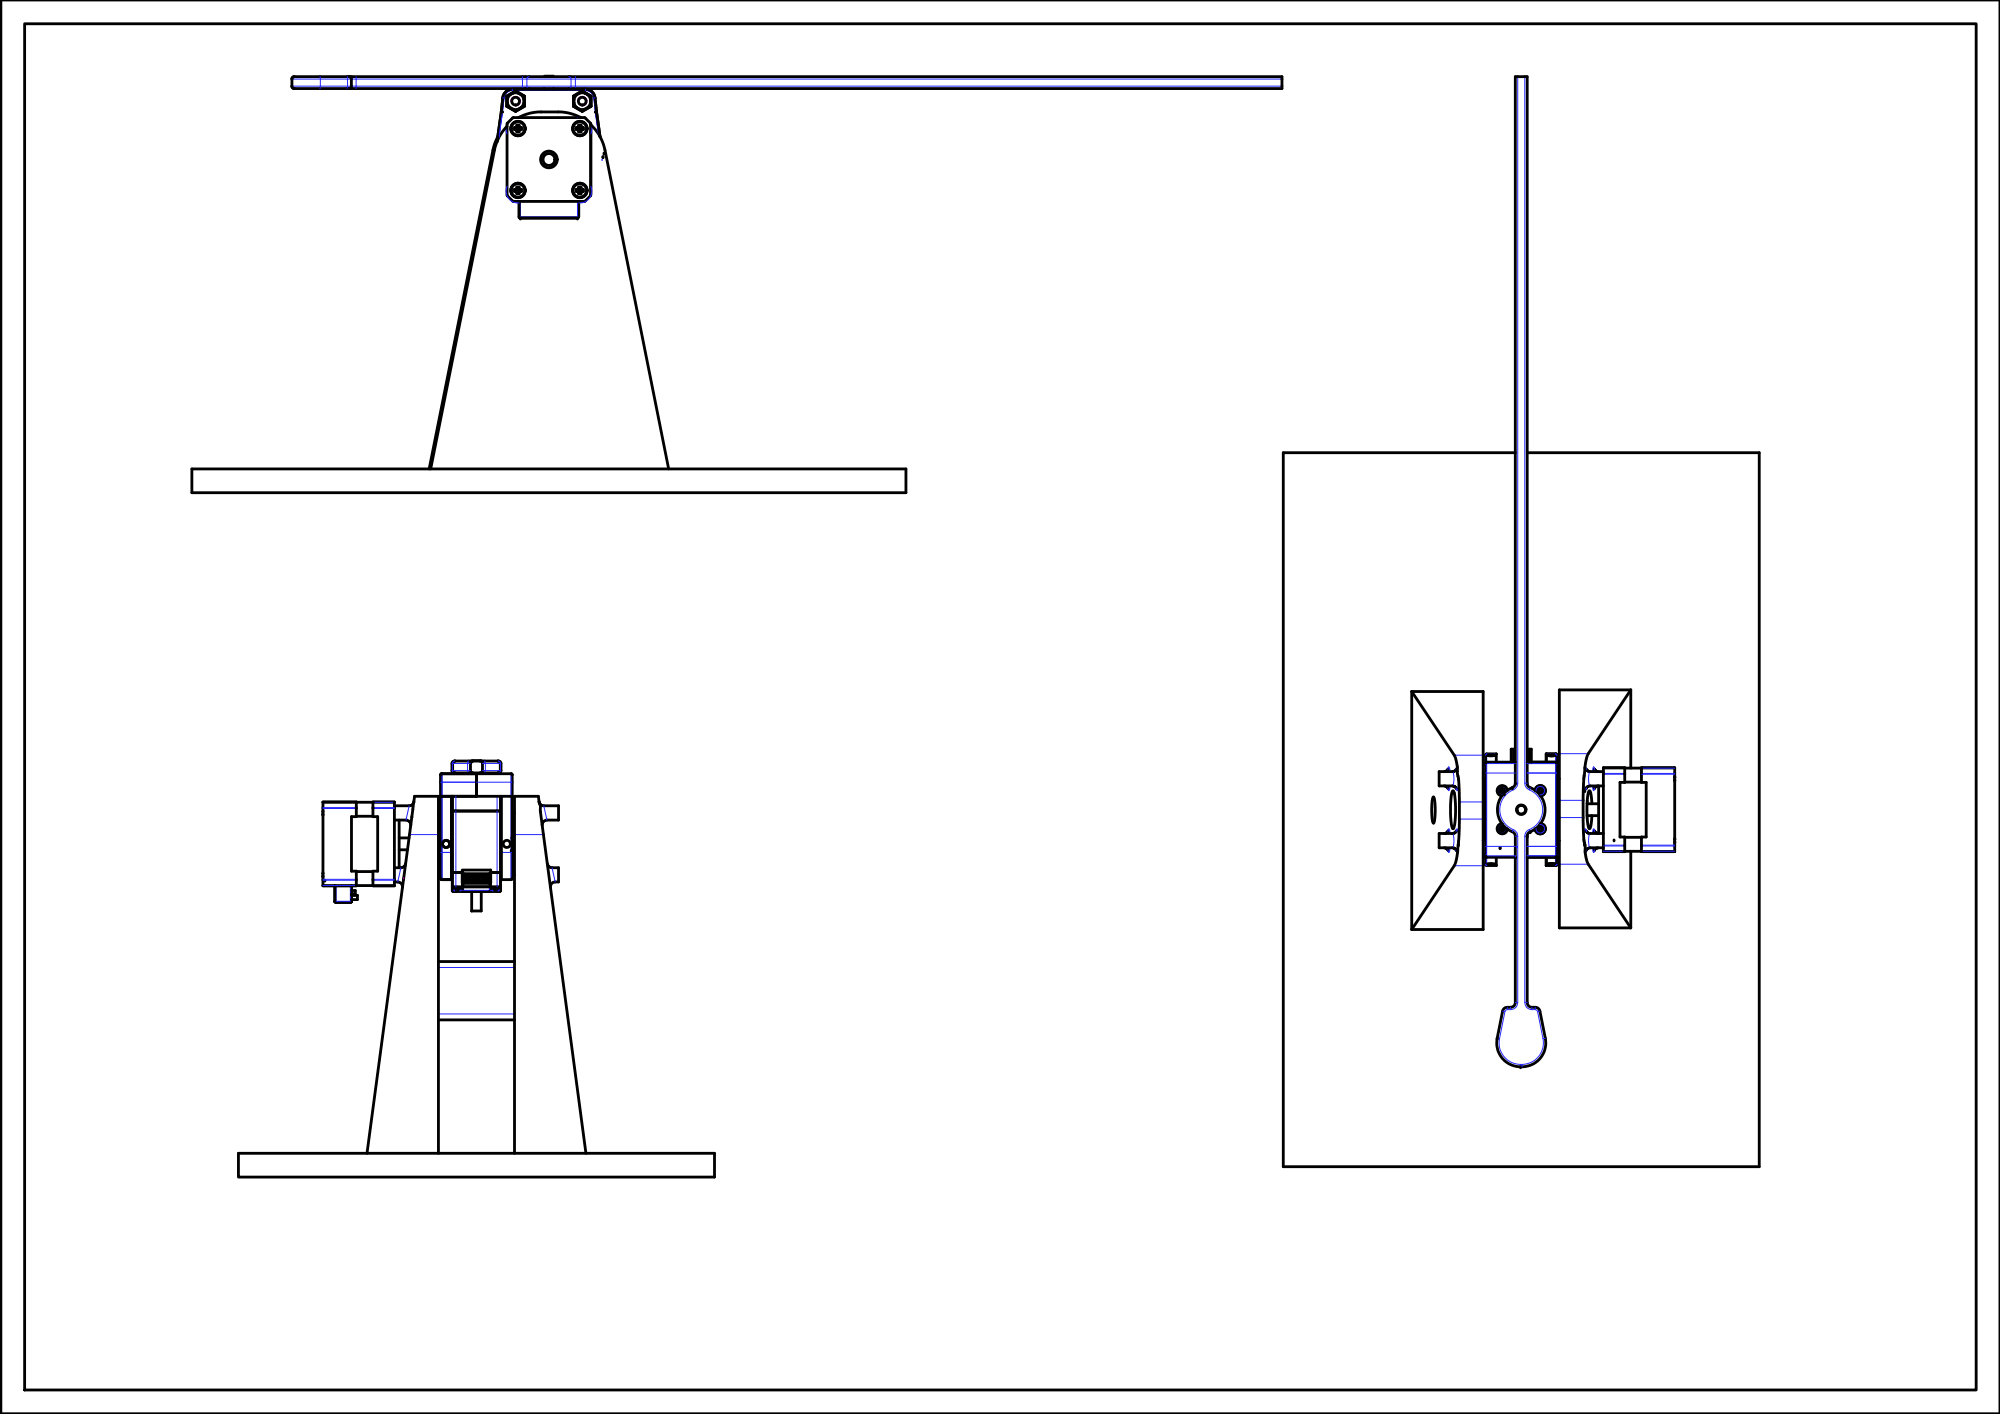
[picture p56: page 1]
