4D-Game/CrazyComet/hardware/models/turrets/turret_final_sketch.pdf

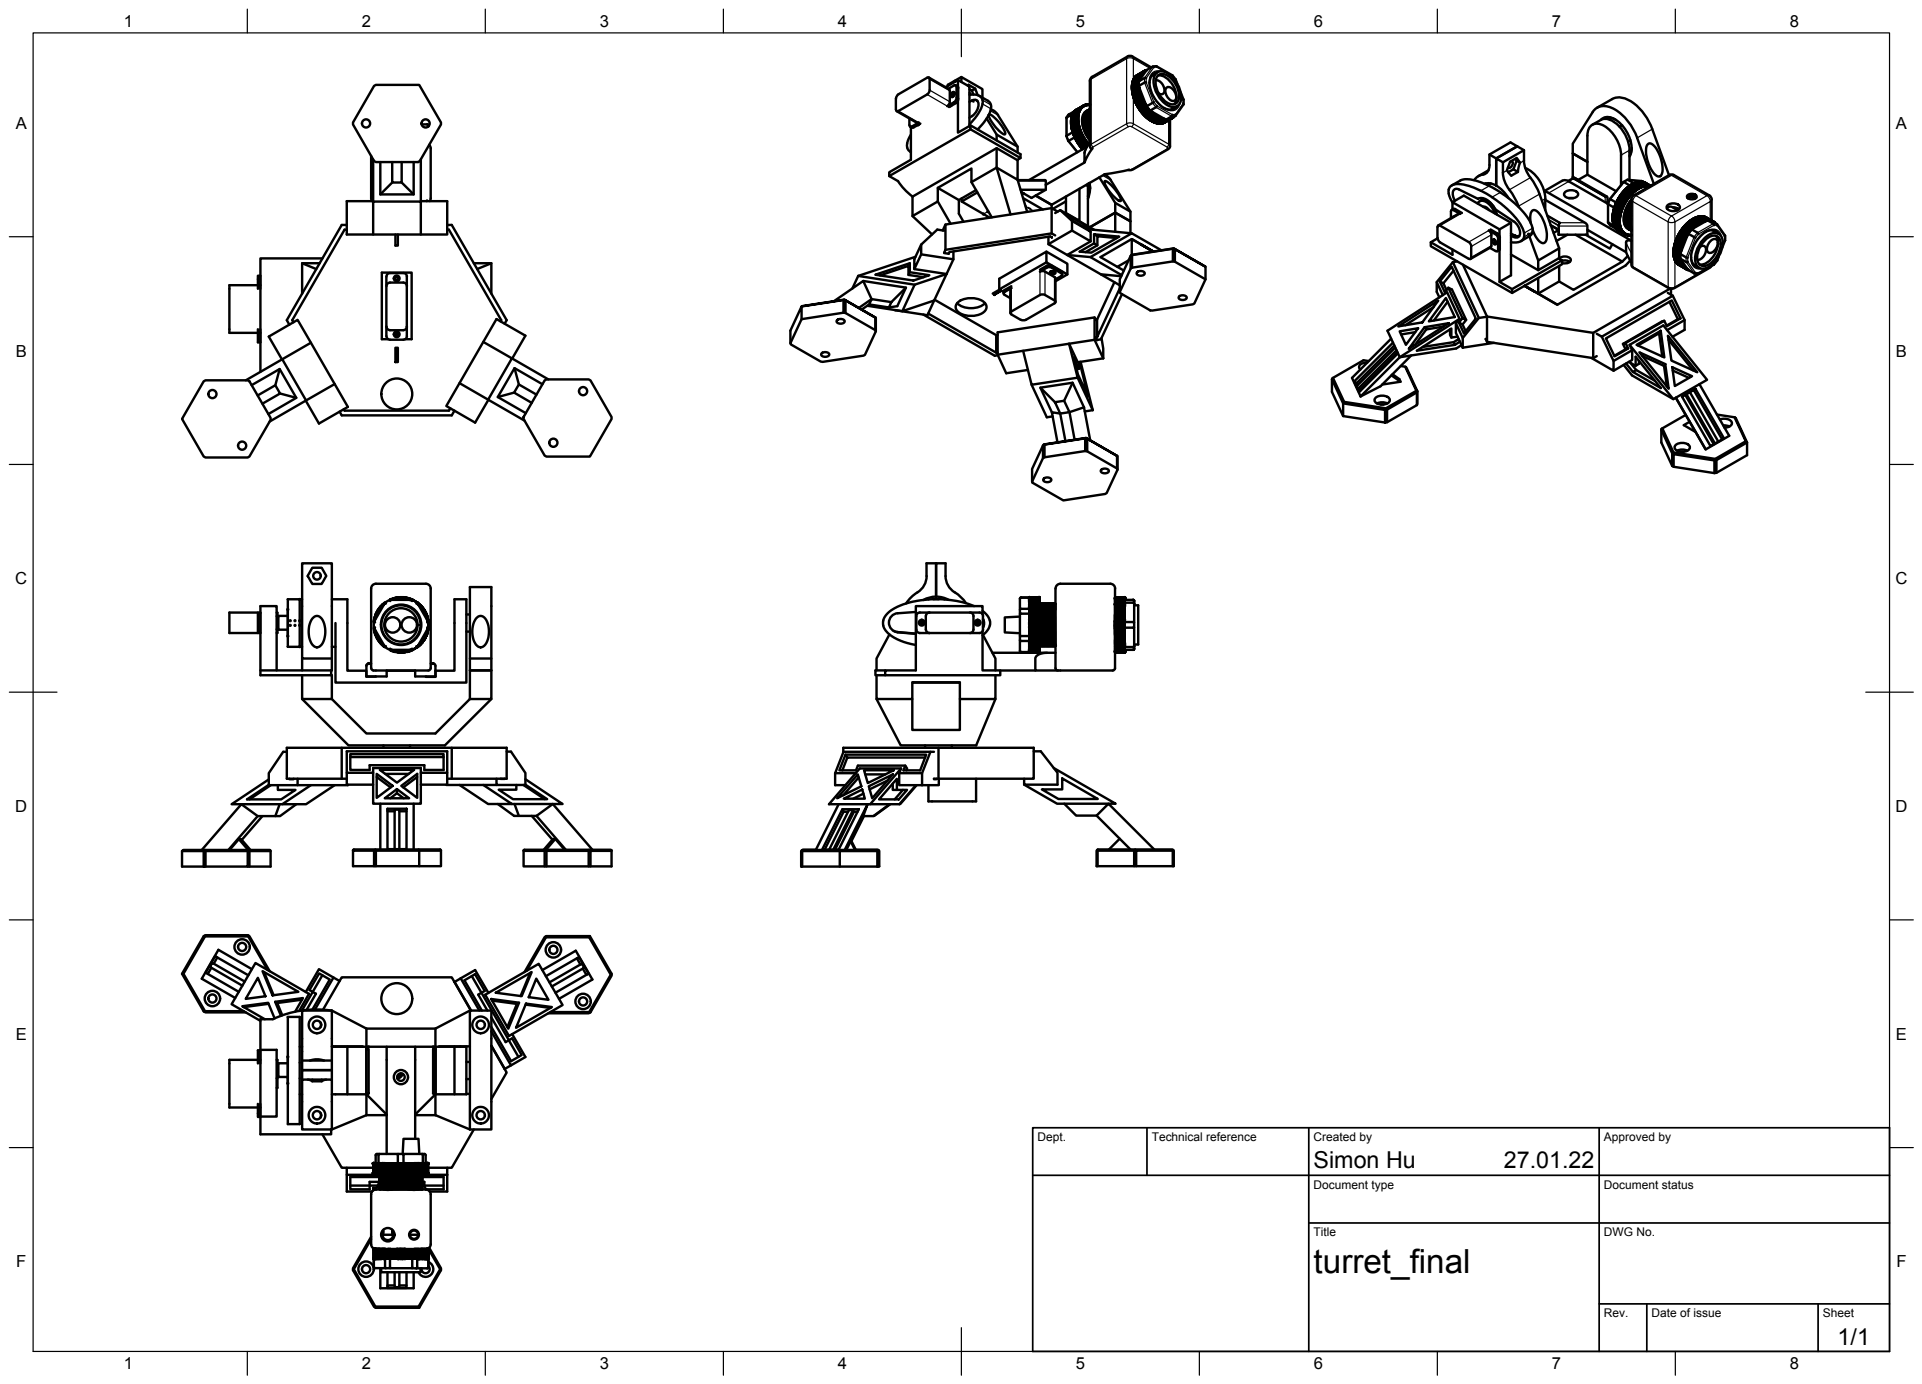
[picture p57: page 1]
Dept.; Technical reference; Created by; Approved by; Document type; Document status; Title; DWG No.; Rev.; Date of issue; Sheet; Simon Hu
