4D-Game/CrazyComet/(commit log)

2021-11-04 REWORK paddle control for turrets
    [turrets.py]
2021-11-04 ADD turretHAL implementation for servo
2021-11-11 ADD mqtt client, ADD connection to mqtt broker
    [main.py]
2021-11-22 ADD XBox 360 Wireless key maps
2021-11-23 ADD input, joystick, switch and gamepad classes, TODO documentation
2021-11-28 turret_test servo_test
2021-11-28 ADD ledTestGame
2021-12-02 ADD pwm
2021-12-02 FIX pwm
2021-12-04 changed values in servo.py
2021-12-05 ADD position control for servo
2021-12-06 ADD relative servo control
2021-12-07 REWORK sdk imports, REMOVE surrogate remains
    [main.py, servo.py, turrets.py]
2021-12-08 ADD test sensor
2021-12-10 FIX turret test after game sdk rework
    [turrets.py]
2021-12-10 ADD overwiev, code-references to documentation ADD missing documentation to turrets.py
    [servo.py, turrets.py]
2021-12-12 REWORK sensor structure
2022-01-10 FIX magazine, ADD gamepad by id, REWORK turrets.py for new servo
    [blaster.py, main.py, servo.py, turrets.py]
2022-01-20 REWORK led classes, ADD callbacks
    [led_hal.py, leds.py, turrets.py]
2022-01-20 REWORK led structure
2022-01-21 FIX pi-setup script, FIX led class
    [turrets.py]
2022-01-21 ADD led functions
2022-01-21 FIX led callback for joystick position
    [main.py]
2022-01-21 ADD blue leds on start, ADD config.toml to gitignore
2022-01-21 ADD spi enable FIX pigpiod enable in pi-setup
2022-01-23 ADD switch leds off on exit
2022-01-23 ADD leds blue on_end
2022-01-24 ADD score leds
2022-01-24 REWORK write led
2022-01-24 FIX LEDs
2022-01-24 FIX lede blink, REWORK vertical turret positions
    [blaster.py, led_hal.py, main.py, turrets.py]
2022-01-25 ADD inverted servo !REWORK config.toml!
    [main.py, servo.py, turrets.py]
2022-01-26 FIX git conflict marker in servo.py
    [servo.py]
2022-01-26 REWORK servo test
2022-01-26 FIX score indicator on RGB LEDs
    [leds.py]
2022-03-05 REMOVE wrong subtree
    [requirements.xlsx]
2022-03-05 REWORK docs structure
    [base.stl, base_mount.stl, base_plate.stl, blaster_arm_v3.stl, display_mount.stl, end_bearing.stl, left_bearing_half.stl, leg.stl]
